Knotenpunkt-NBG/forcelog-adc/pcb/pcb_motherboard_dev/doku/pcb_motherboard_dev.png

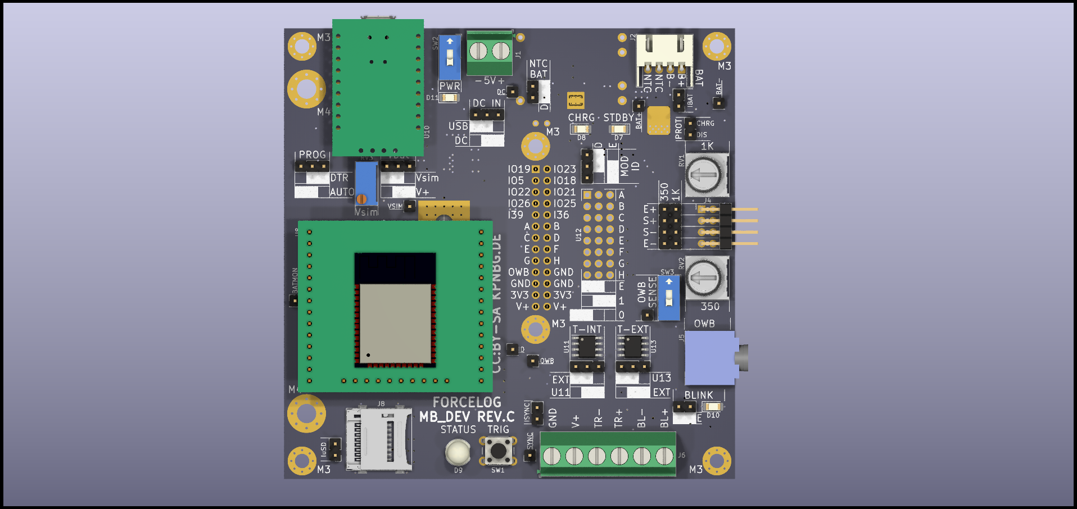
pcb/pcb_motherboard_dev/doku/pcb_motherboard_dev.png
