Knotenpunkt-NBG/forcelog-adc/firmware_forcelogADC/diagrams/flow_at_boot.pdf

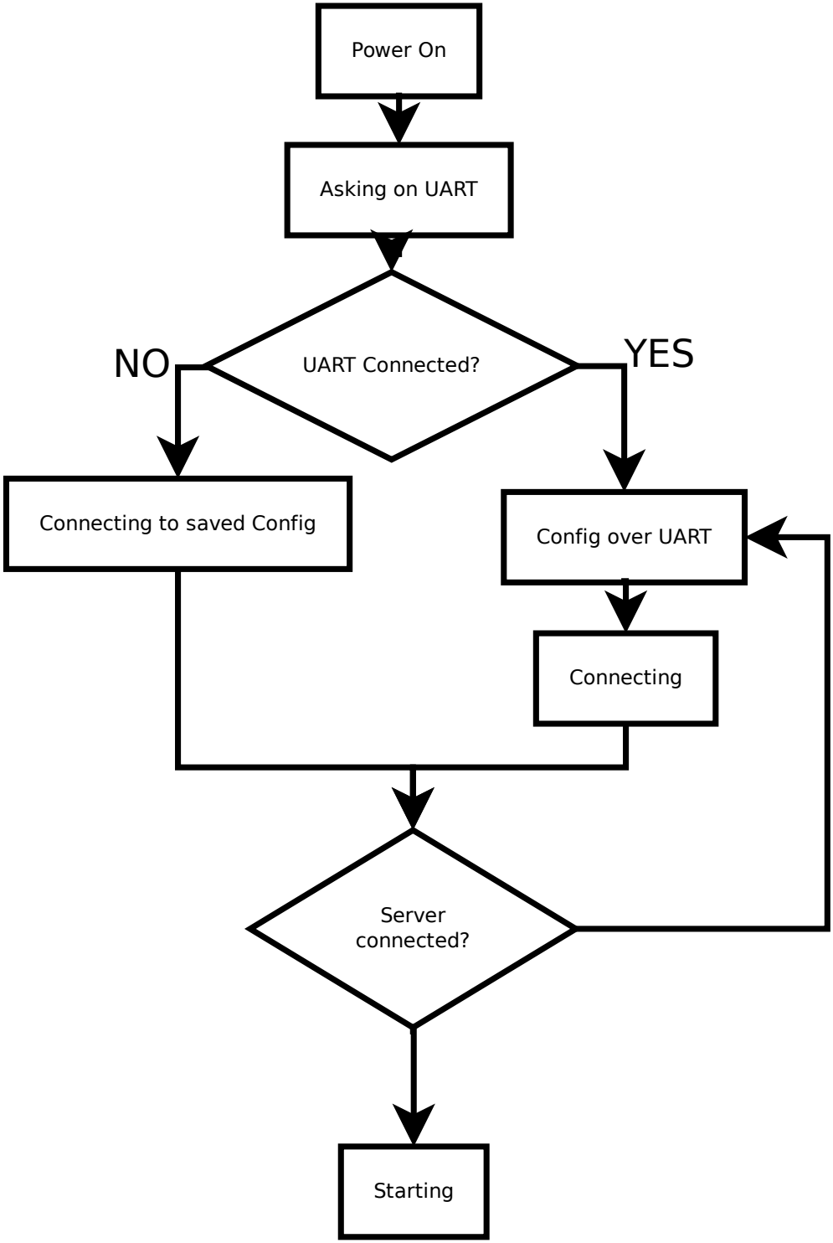
[picture p2: figure]
Power On; Asking on UART; UART Connected?; Connecting to saved Config; Config over UART; Connecting; Server connected?; Starting; YES
