Knotenpunkt-NBG/forcelog-adc/bom.ods

Stk | Value | Datasheet | da? | Prize | Gesamt
Reichelt |  |  |  |  |  | 267.79 | 435.14
8 | 10µ CER | https://www.reichelt.de/vielschicht-kerko-10-f-16v-125-c-kem-x7r1206-10u-p207163.html?trstct=pol_0&nbc=1 | 0 | 0.13 | 1.04
45 | 10µ Elko | https://www.reichelt.de/smd-elko-10-f-50-v-2000-h-eln-rv2-50v100mu-p246741.html?&trstct=pol_2&nbc=1 | 0 | 0.11 | 4.95
8 | 1n | https://www.reichelt.de/vielschicht-kerko-1-0nf-50v-125-c-kem-x7r1206-1-0n-p207139.html?trstct=pol_4&nbc=1 | 0 | 0.02 | 0.16
4 | 47n | https://www.reichelt.de/vielschicht-kerko-47nf-100v-125-c-kem-x7r1206-47n-p207148.html?trstct=pol_4&nbc=1 | 0 | 0.08 | 0.32
4 | 82n CER | https://www.reichelt.de/vielschicht-kerko-82nf-50v-125-c-kem-x7r1206-82n-p207150.html?trstct=pol_0&nbc=1 | 0 | 0.09 | 0.36
111 | 100n | https://www.reichelt.de/vielschicht-kerko-100nf-50v-125-c-kem-x7r1206b100n-p207152.html?trstct=pol_0&nbc=1 | 0 | 0.04 | 4.44
15 | 1µ | https://www.reichelt.de/vielschicht-kerko-1-0-f-25v-85-c-kem-y5v1206-1-0u-p207164.html?trstct=pol_0&nbc=1 | 0 | 0.05 | 0.75
2 | 2µ2 | https://www.reichelt.de/smd-kerko-1206-2-2-f-10-v-10-mlcc-rnd-1501206b2251-p225544.html?trstct=pol_0&nbc=1 | 0 | 0.02 | 0.04
20 | BAT54 | https://www.reichelt.de/schottkydiode-30-v-0-2-a-sod-323f-bat-54j-nxp-p219408.html?trstct=pos_9&nbc=1 | 0 | 0.06 | 1.2
2 | 1N4148 | https://www.reichelt.de/schalt-diode-75-v-150-ma-sod-323f-1n-4148-ws-p95197.html?&trstct=pos_3&nbc=1 | 0 | 0.04 | 0.08
8 | Terminal Block 2p | https://www.reichelt.de/loetbare-schraubklemme-2-pol-rm-5-mm-90-rnd-205-00012-p170244.html?trstct=pol_3&nbc=1 | 0 | 0.2 | 1.6
8 | Terminal Block 4p | https://www.reichelt.de/loetbare-schraubklemme-4-pol-rm-5-mm-90-rnd-205-00003-p170224.html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 | 0 | 0.35 | 2.8
4 | Terminal Block 5p | https://www.reichelt.de/loetbare-schraubklemme-5-pol-rm-5-mm-90-rnd-205-00004-p170225.html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 | 0 | 0.45 | 1.8
4 | 470 THT | https://www.reichelt.de/widerstand-metallschicht-470-ohm-0207-0-6-w-1-metall-470-p11826.html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 | 0 | 0.08 | 0.32
4 | 910 THT | https://www.reichelt.de/widerstand-metallschicht-910-ohm-0207-0-6-w-1-metall-910-p12035.html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 | 0 | 0.08 | 0.32
10 | 100 | https://www.reichelt.de/smd-widerstand-1206-100-ohm-250-mw-1-rnd-1206-1-100-p183349.html?trstct=pol_1&nbc=1 | 0 | 0.02 | 0.2
6 | 100 0.1% | https://www.reichelt.de/smd-widerstand-1206-100-ohm-250-mw-0-1-pan-era8aeb101v-p238078.html?trstct=pol_1&nbc=1 | 0 | 0.4 | 2.4
4 | 1k 0.1% | https://www.reichelt.de/smd-widerstand-1206-1-0-kohm-250-mw-0-1-pan-era8aeb102v-p238079.html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 | 0 | 0.4 | 1.6
4 | 150 | https://www.reichelt.de/smd-widerstand-1206-150-ohm-250-mw-1-rnd-1206-1-150-p183351.html?trstct=pol_0&nbc=1 | 0 | 0.02 | 0.08
5 | 270 | https://www.reichelt.de/smd-widerstand-1206-270-ohm-250-mw-1-rnd-1206-1-270-p183355.html?trstct=pol_0&nbc=1 | 0 | 0.02 | 0.1
22 | 470 | https://www.reichelt.de/smd-widerstand-1206-470-ohm-250-mw-1-rnd-1206-1-470-p183358.html?trstct=pol_0&nbc=1 | 0 | 0.02 | 0.44
5 | 750 | https://www.reichelt.de/smd-widerstand-1206-750-ohm-250-mw-1-koa-rk73h2bttd71-p238075.html?trstct=pol_2&nbc=1 | 0 | 0.02 | 0.1
13 | 910 | https://www.reichelt.de/smd-widerstand-1206-910-ohm-250-mw-1-rnd-1206-1-910-p212738.html?trstct=pol_0&nbc=1 | 0 | 0.02 | 0.26
5 | 1k5 | https://www.reichelt.de/smd-widerstand-1206-1-5-kohm-250-mw-1-rnd-1206-1-1-5k-p183381.html?trstct=pol_0&nbc=1 | 0 | 0.02 | 0.1
9 | 120 | https://www.reichelt.de/smd-widerstand-1206-120-ohm-250-mw-1-rnd-1206-1-120-p183350.html?trstct=pol_1&nbc=1 | 0 | 0.02 | 0.18
9 | 91 | https://www.reichelt.de/smd-widerstand-1206-91-ohm-250-mw-1-rnd-1206-1-91-p212729.html?trstct=pol_0&nbc=1 | 0 | 0.02 | 0.18
20 | 22 | https://www.reichelt.de/smd-widerstand-1206-22-ohm-250-mw-1-rnd-1206-1-22-p183340.html?trstct=pol_0&nbc=1 | 0 | 0.02 | 0.4
80 | 10k | https://www.reichelt.de/smd-widerstand-1206-10-kohm-250-mw-1-rnd-1206-1-10k-p183394.html?trstct=pol_1&nbc=1 | 0 | 0.02 | 1.6
4 | 1k | https://www.reichelt.de/smd-widerstand-1206-1-0-kohm-250-mw-1-rnd-1206-1-1-0k-p183379.html?trstct=pol_1&nbc=1 | 0 | 0.02 | 0.08
4 | 1k | https://www.reichelt.de/praezisionspotentiometer-25-gaenge-stehend-1-0-kohm-64w-1-0k-p2694.html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 | 0 | 0.31 | 1.24
6 | 7805 | https://www.reichelt.de/spannungsregler-fest-5-v-dpak-mc-7805-cdtg-p189143.html?&trstct=pos_8&nbc=1 | 0 | 0.35 | 2.1
6 | 74HC165 | https://www.reichelt.de/shift-register-8-bit-2-6-v-so-16-74hc-165d-nxp-p216626.html?trstct=pos_2&nbc=1 | 0 | 0.24 | 1.44
6 | DS18B20 | https://www.reichelt.de/digital-thermometer-1-wire-0-5-c-to-92-ds-18b20-p58169.html?trstct=pos_0&nbc=1 | 0 | 1.65 | 9.9
24 | 20Pin | https://www.reichelt.de/20pol-buchsenleiste-gerade-rm-2-54-h-8-5mm-bl-1x20g8-2-54-p51827.html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 | 0 | 0.27 | 6.48
19 | 40Pin | https://www.reichelt.de/40pol-stiftleiste-gerade-rm-2-54-sl-1x40g-2-54-p19506.html?trstct=pol_0&nbc=1 | 0 | 0.22 | 4.18
56 | Jumper | https://www.reichelt.de/kurzschlussbruecke-schw-m-grifflasche-jumper-2-54gl-sw-p9019.html?trstct=pol_2&nbc=1 | 0 | 0.03 | 1.68
17 | JST XH2P | https://www.reichelt.de/jst-stiftleiste-gerade-1x2-polig-xh-jst-xh2p-st-p185073.html?trstct=pos_7&nbc=1 | 0 | 0.08 | 1.36
15 | JST XH 4P | https://www.reichelt.de/jst-stiftleiste-gerade-1x4-polig-xh-jst-xh4p-st-p185075.html?trstct=pol_12&nbc=1 | 0 | 0.15 | 2.25
7 | JST XH 5P | https://www.reichelt.de/jst-stiftleiste-90-1x5-polig-xh-jst-xh5p-st90-p185082.html?trstct=pos_0&nbc=1 | 0 | 0.17 | 1.19
1 | JST XH8P | https://www.reichelt.de/jst-stiftleiste-gerade-1x8-polig-xh-jst-xh8p-st-p185078.html?trstct=pos_0&nbc=1 | 0 | 0.25 | 0.25
8 | 2N7002 | https://www.reichelt.de/mosfet-n-ch-60v-0-115a-0-3w-sot-23-2n-7002-7-f-p219153.html?trstct=pos_2&nbc=1 | 0 | 0.03 | 0.24
5 | KFV 80 | https://www.reichelt.de/einbaukupplung-frontmontage-ip40-8-pol-lum-kfv-80-p116111.html?trstct=pos_0&nbc=1 | 0 | 4.1 | 20.5
5 | KFV 40 | https://www.reichelt.de/einbaukupplung-frontmontage-ip40-4-pol-lum-kfv-40-p116109.html?trstct=pos_0&nbc=1 | 0 | 2.75 | 13.75
5 | KFV 50 | https://www.reichelt.de/einbaukupplung-frontmontage-ip40-5-pol-180-lum-kfv-50-p116110.html?trstct=pol_4&nbc=1 | 0 | 3.2 | 16
12 | Jst XH 2p FEM | https://www.reichelt.de/jst-buchsengehaeuse-1x2-polig-xh-jst-xh2p-bu-p185085.html?trstct=pos_2&nbc=1 | 0 | 0.04 | 0.48
20 | Jst XH 4p FEM | https://www.reichelt.de/jst-buchsengehaeuse-1x4-polig-xh-jst-xh4p-bu-p185087.html?trstct=pos_2&nbc=1 | 0 | 0.06 | 1.2
7 | Jst XH 5p FEM | https://www.reichelt.de/jst-buchsengehaeuse-1x5-polig-xh-jst-xh5p-bu-p185088.html?trstct=pos_1&nbc=1 | 0 | 0.04 | 0.28
1 | Jst XH 8p FEM | https://www.reichelt.de/jst-buchsengehaeuse-1x8-polig-xh-jst-xh8p-bu-p185090.html?trstct=pos_0&nbc=1 | 0 | 0.25 | 0.25
200 | Crimp JST XH | https://www.reichelt.de/jst-crimpkontakt-buchse-xh-jst-xh-ckb-p185091.html?&trstct=pol_0&nbc=1 | 0 | 0.03 | 6 |  | 147
2 | LTC2440CGN | https://www.reichelt.de/index.html?ACTION=446&LA=446&nbc=1&q=ltc2440 | 0 | 12.3 | 24.6
1 | Alugehäuse | https://www.reichelt.de/alugehaeuse-26-x-34-6-x-86-6-mm-aluminium-rnd-455-00848-p222399.html?r=1 | 0 | 2.2 | 2.2
1 | Kabel | https://www.reichelt.de/unitronic-liyy-50-m-8-x-0-25-liyy-8x0-25-50-p166031.html?&trstct=pol_0&nbc=1 | 0 | 31.6 | 31.6
1 | Kabel | https://www.reichelt.de/unitronic-liycy-50-m-4-x-0-25-liycy-4x0-25-50-p165979.html?trstct=vrt_pdn&nbc=1 | 0 | 31.2 | 31.2
2 | Kabelverschraubung | https://www.reichelt.de/kabelverschraubung-m-12-x-1-5-3-7-mm-silbergrau-ip69k-lapp-53112000-p158642.html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 | 0 | 1.99 | 3.98
1 | 5mm grün | https://www.reichelt.de/led-5-mm-bedrahtet-gruen-620-mcd-10-evl-333-2sygc-s5-p230907.html?trstct=pol_2&nbc=1 | 0 | 0.08 | 0.08
1 | 5mm gelb | https://www.reichelt.de/led-5-mm-bedrahtet-gelb-4200-mcd-6-evl-383-2uyc-s53-p230927.html?trstct=pol_3&nbc=1 | 0 | 0.09 | 0.09
2 | 5mm blau | https://www.reichelt.de/led-5-mm-bedrahtet-blau-2000-mcd-10-led-el-5-2000bl-p156268.html?trstct=pol_5&nbc=1 | 0 | 0.14 | 0.28
1 | Stecker Micro USB | https://www.reichelt.de/micro-usb-stecker-typ-b-5-polig-usb-micro-st-p124013.html?trstct=pol_12&nbc=1 | 0 | 0.85 | 0.85
4 | M3x10 FF | https://www.reichelt.de/distanzhuelsen-metall-6-kant-m3-10mm-di-10mm-p7119.html?&trstct=pol_10&nbc=1 | 0 | 0.11 | 0.44
1 | Schrumpfschlauch | https://www.reichelt.de/schrumpfschlauch-box-12m-transparent-6-4mm-sdb-6-4-tr-p53811.html?trstct=pol_6&nbc=1 | 0 | 3.3 | 3.3
5 | Blue 5mm | https://www.reichelt.de/led-5-mm-bedrahtet-blau-4000-mcd-16-kbt-l-7113qbc-g-p230952.html?trstct=pol_1&nbc=1 | 0 | 0.52 | 2.6
5 | IR 5mm | https://www.reichelt.de/ir-led-850-nm-5-mm-hir-7373b-l289-p216812.html?&trstct=pos_9&nbc=1 | 0 | 0.23 | 1.15
5 | IR 5mm | https://www.reichelt.de/ir-led-940-nm-5-mm-ir-7373c-evl-p219706.html?&trstct=pos_10&nbc=1 | 0 | 0.13 | 0.65
5 | Lumberg SV 40 | https://www.reichelt.de/stecker-sv-40-rundsteckverbinder-gerade-ip40-4-pol-lum-sv-40-p136906.html?r=1 | 0 | 4.15 | 20.75
5 | SV 50 | https://www.reichelt.de/stecker-sv-50-rundsteckverbinder-gerade-ip40-5-pol-180-lum-sv-50-p248561.html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 | 0 | 4.15 | 20.75
1 | Lumberg SV80 | https://www.reichelt.de/stecker-sv-80-rundsteckverbinder-gerade-ip40-8-pol-lum-sv-80-p116087.html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 | 0 | 4.6 | 4.6
Banggood |  |  |  |  |  | 1.66
5 | FT232breakout | https://www.banggood.com/FT232RL-FT232-RS232-FTDI-Micro-USB-to-TTL-3_3V-5_5V-Serial-Adapter-Module-Download-Cable-for-Mini-Port-p-1599806.html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 | 1 | 2.78 | 0
9 | BoostConverter | https://www.banggood.com/DC-2V-24V-To-5V-28V-2A-Step-Up-Boost-Converter-Power-Supply-Module-Adjustable-Regulator-Board-p-1566600.html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 | 1 | 1.29 | 0
9 | BuckConverter | https://www.banggood.com/DC-DC-7-28V-to-5V-3A-Step-Down-Power-Supply-Module-Buck-Converter-Replace-LM2596-p-1536688.html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 | 1 | 1.23 | 0
9 | W25Q128 | https://www.banggood.com/W25Q32-W25Q128-Large-Capacity-FLASH-Storage-Module-Memory-Card-SPI-Interface-BV-FV-STM32-p-1595134.html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 | 1 | 1.28 | 0
7 | HX711 | https://www.banggood.com/3pcs-AD-Weighing-Sensor-Module-Dual-channel-24-bit-AD-Conversion-HX711-Shieding-p-1355706.html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 | 1 | 0.97 | 0
5 | TP4056withprotect | https://www.banggood.com/TP4056-Micro-USB-5V-1A-Lithium-Battery-Charging-Module-Board-TE585-Lipo-Charger-p-1225993.html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 | 1 | 1.26 | 0
5 | Battery Holder | https://www.banggood.com/DIY-1-Slot-18650-Battery-Holder-With-2-Leads-p-972775.html?rmmds=search | 1 | 1.38 | 0
5 | Button | https://www.banggood.com/DC-12V-4-Pin-12mm-Latching-Switch-Led-Light-Metal-Push-Button-Switch-p-1196609.html?ID=229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 | 1 | 3.04 | 0
1 | RGB LED | https://www.banggood.com/10pcs-5mm-RGB-LED-Common-Anode-4-Pin-Tri-Color-Emitting-Diodes-F5-p-937446.html?ID=513798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 | 0 | 1.66 | 1.66
Aliexpress |  |  |  |  |  | 0
3 | Antenne SMA | https://de.aliexpress.com/item/32971789201.html?spm=a2g0s.9042311.0.0.720a4c4drGYyPu | 1 | 1.5 | 0
1 | Kabel | https://www.aliexpress.com/item/4000515927742.html?spm=a2g0s.9042311.0.0.7b694c4d2qJnZR | 1 | 10.29 | 0
5 | 5cm SMA-u.FL | https://www.aliexpress.com/item/4000339663959.html?spm=a2g0s.9042311.0.0.7b694c4d2qJnZR | 1 | 0.44 | 0
Digikey |  |  |  |  |  | 156.81
4 | ESP32-wroom-32 | https://www.digikey.de/product-detail/en/espressif-systems/ESP32-WROOM-32-16MB/1904-1020-1-ND/9381729 | 0 | 4.13 | 16.52
5 | ESP32-WROOM-32U | https://www.digikey.de/product-detail/en/espressif-systems/ESP32-WROOM-32U-16MB/1904-1028-1-ND/9381737 | 0 | 4.13 | 20.65
10 | Shield | https://www.digikey.de/product-detail/en/te-connectivity-amp-connectors/2118726-2/A126157CT-ND/7381917 | 0 | 1.42 | 14.2
10 | Shield Cover | https://www.digikey.de/product-detail/en/2118725-2/A126130-ND/7381869/?itemSeq=321839437 | 0 | 0.61 | 6.1
5 | Si4403DDY | https://www.digikey.de/product-detail/en/vishay-siliconix/SI4403DDY-T1-GE3/SI4403DDY-T1-GE3CT-ND/7622821 | 0 | 0.42 | 2.1
5 | 1550Z113 | https://www.digikey.de/product-detail/en/hammond-manufacturing/1550Z113/HM190-ND/2268551 | 0 | 12.88 | 64.4
6 | LED Mount | https://www.digikey.de/products/en?keywords=1528-1397-ND | 0 | 0.59 | 3.54
4 | IRF7343PBF | https://www.digikey.de/product-detail/en/infineon-technologies/IRF7343TRPBF/IRF7343PBFCT-ND/812557 | 0 | 0.95 | 3.8
4 | 10 0.1% | https://www.digikey.de/product-detail/en/bourns-inc/CRT1206-BY-10R0ELF/CRT1206-BY-10R0ELFCT-ND/1775050 | 0 | 0.59 | 2.36
2 | LT1492 | https://www.digikey.de/product-detail/en/linear-technology-analog-devices/LT1492CS8-PBF/LT1492CS8-PBF-ND/889428 | 0 | 8.12 | 16.24
2 | lt1461 | https://www.digikey.de/product-detail/en/linear-technology-analog-devices/LT1461CCS8-3-PBF/LT1461CCS8-3-PBF-ND/889264 | 0 | 3.45 | 6.9
Wegertseder |  |  |  |  |  | 8.88
50 | ISO7380 M4x8 | https://www.wegertseder.com/ArticleDetails.aspx?AKNUM=2576&Diameter=4 | 0 | 0.039 | 1.95
100 | Iso7380 M3x6 | https://www.wegertseder.com/ArticleDetails.aspx?AKNUM=2576&Diameter=3 | 0 | 0.0238 | 2.38
100 | DIN 7991 M4x20 | https://www.wegertseder.com/ArticleDetails.aspx?AKNUM=2608&Diameter=4 | 0 | 0.0455 | 4.55
