Knotenpunkt-NBG/forcelog-adc/mechanical/ENCLOSURE_1550Z113_LID.step

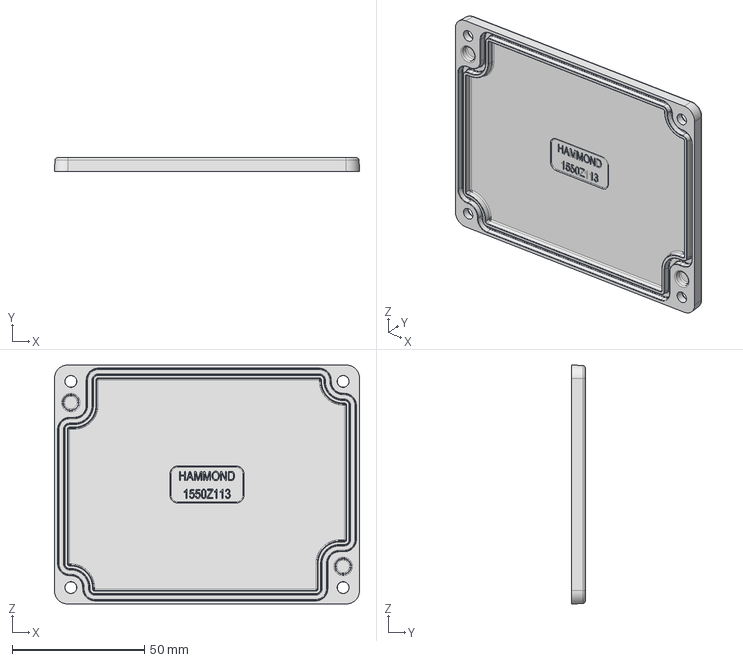
[picture p4: CAD file, 2021-02-28]
mechanical/ENCLOSURE_1550Z113_LID.step
115.4 x 5.20 x 90.4 mm
