Knotenpunkt-NBG/forcelog-adc/mechanical/ENCLOSURE_1550Z113_BOX.step

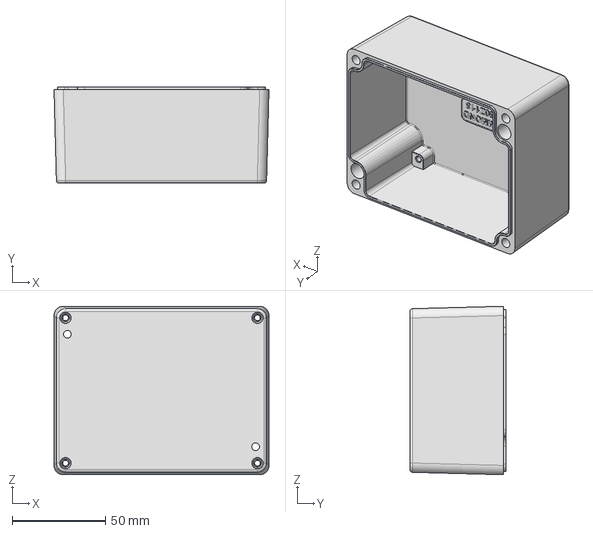
[picture p5: CAD file, 2021-02-28]
mechanical/ENCLOSURE_1550Z113_BOX.step
115.4 x 51.7 x 90.4 mm
