Knotenpunkt-NBG/forcelog-adc/(list of files, cad)

Other CAD files:
mechanical/FORCELOG_ADC_MAIN.FCStd
mechanical/ENCLOSURE_1550Z113_BOX.FCStd
