Knotenpunkt-NBG/forcelog-adc/firmware_forcelogADC/styleguide.ods

StyleGuide
Handler:
h_divide_name
Tasks
t_camelCase
Variables
f_CamelCase
Key:
k_camelCase
Function
camelCase
