Knotenpunkt-NBG/forcelog-adc/(threads)

Thread 2 (2021-12-22):

Acks geradeziehen

knoterich, 2021-12-22:
Bei zweistufigen Eingaben soll bei Eingabeaufforderung \1|\2user\3| an den collector geschickt werden und kein Ack.

knoterich, 2021-12-22:
für Errors sollen auch die entsprechenden Befehle zuückgeben (e.g. |bdur|0) und nicht |err|
