Knotenpunkt-NBG/forcelog-adc/pcb/pcb_motherboard_dev/pcb_motherboard_dev.kicad_pcb

## KiCad design pcb/pcb_motherboard_dev/pcb_motherboard_dev.kicad_pcb (2022-08-03)

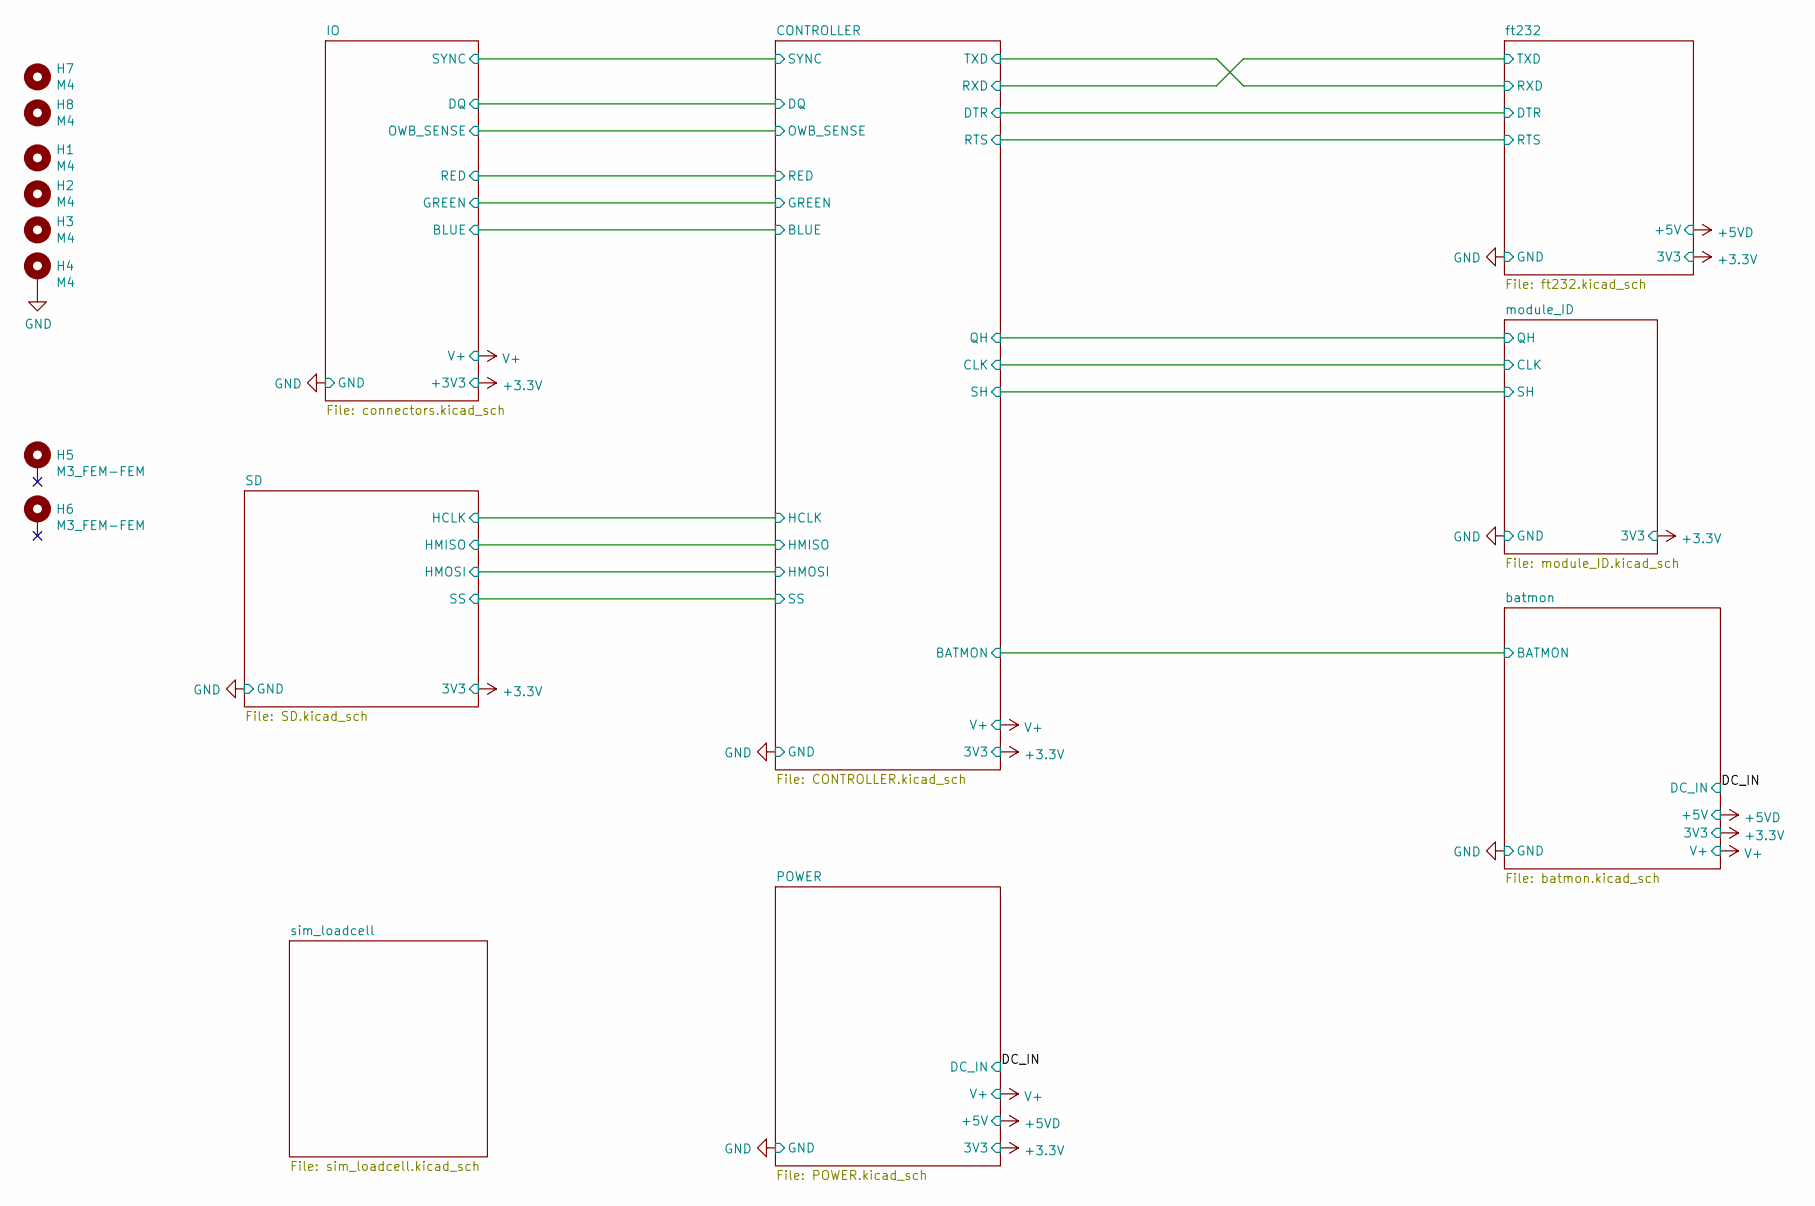
[picture p6: schematic pcb_motherboard_dev.kicad_sch]

Parts:
H1, H7: M4; MountingHole_4.3mm_M4_Pad_Via
H2, H3, H4, H8: M4; MountingHole_3.2mm_M3_Pad_Via
H5, H6: M3_FEM-FEM; MountingHole_3.2mm_M3_Pad_Via

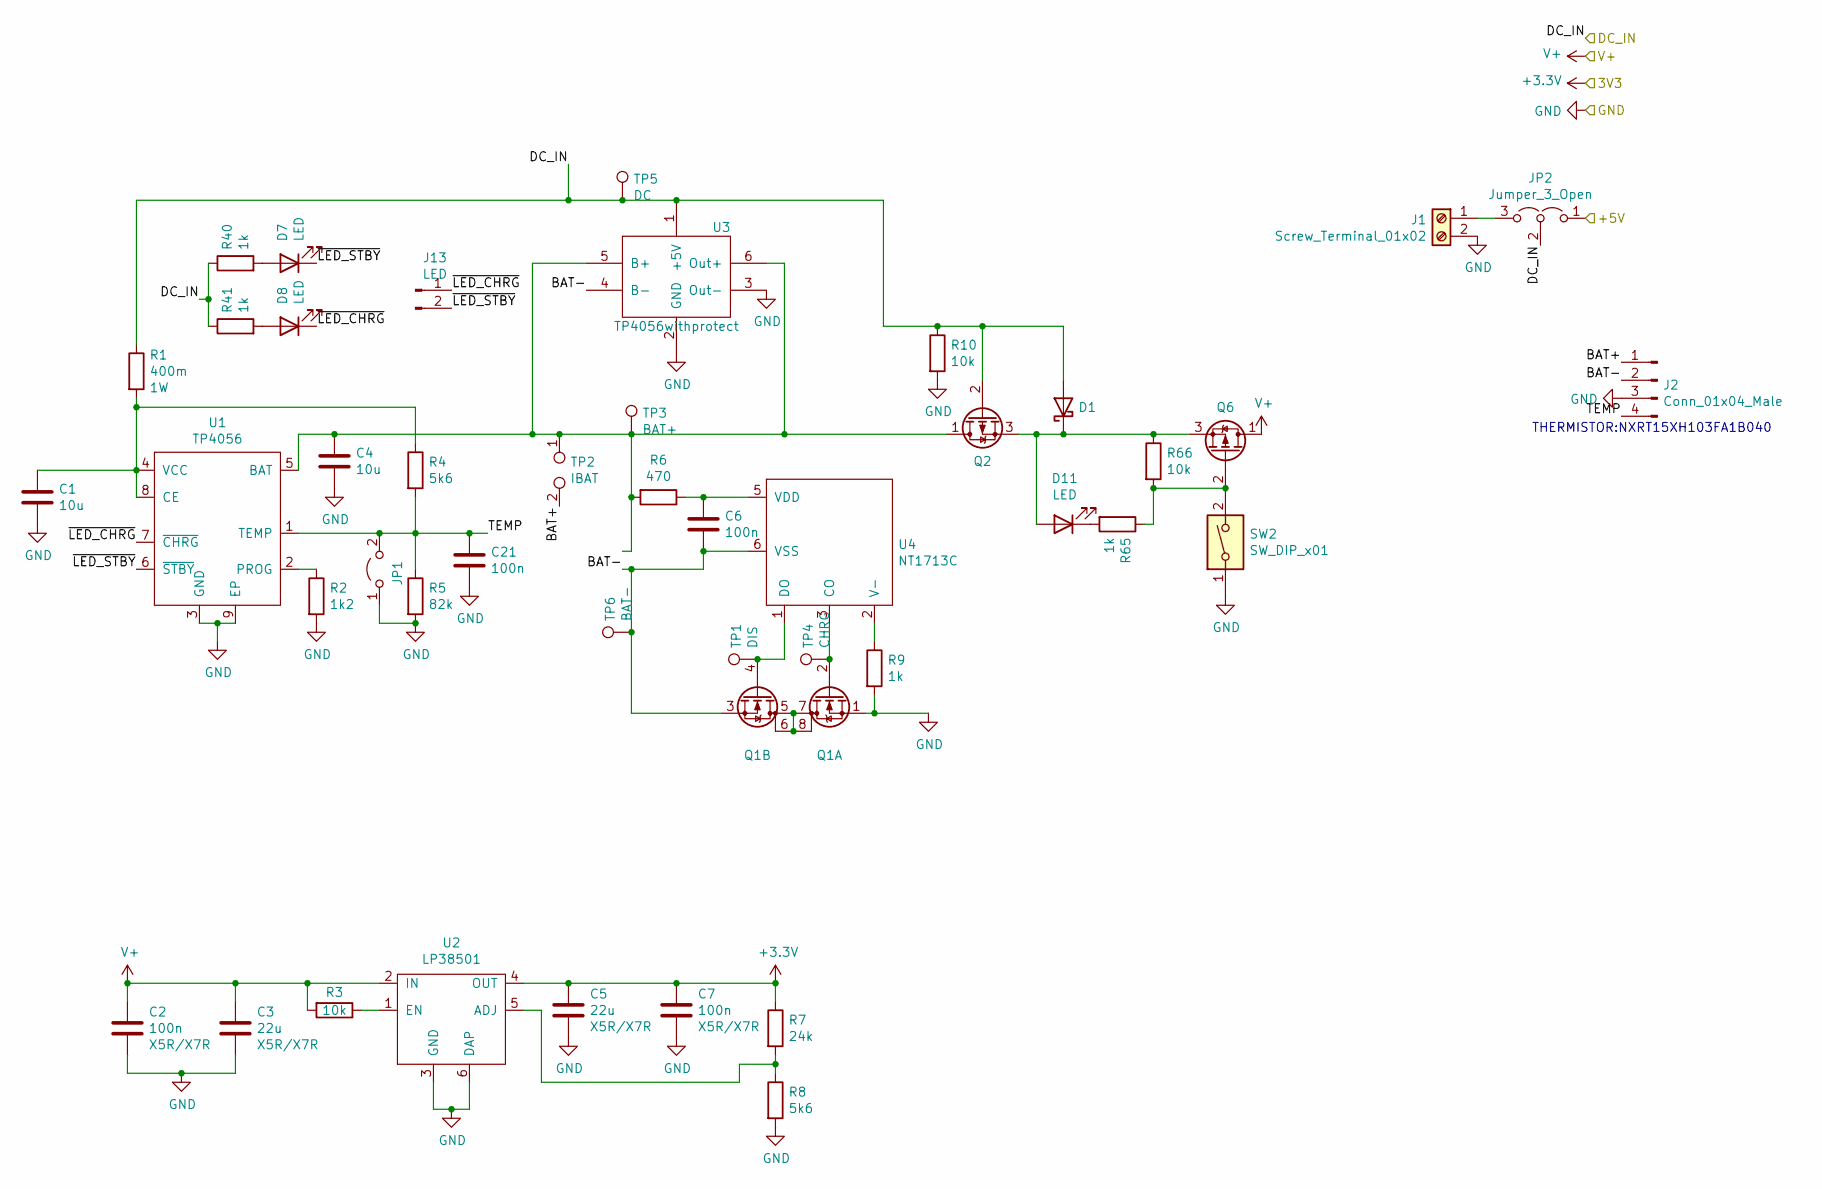
[picture p7: schematic POWER.kicad_sch]

Parts:
C1, C4: 10u; C_1206_3216Metric_Pad1.33x1.80mm_HandSolder; Digikey 1276-1075-1-ND
C2, C6, C7, C21: 100n; C_1206_3216Metric_Pad1.33x1.80mm_HandSolder; Digikey 399-C1206C104K5RAC7800CT-ND
C3, C5: 22u; C_1206_3216Metric_Pad1.33x1.80mm_HandSolder; Digikey 1276-2728-1-ND
D1: PMEG3030EP,115; D_SOD-128; Digikey 1727-5324-1-ND
D7, D11: LED; LED_1206_3216Metric_Pad1.42x1.75mm_HandSolder; Digikey 732-5032-1-ND
D8: LED; LED_1206_3216Metric_Pad1.42x1.75mm_HandSolder; Digikey 732-5034-1-ND
J1: Screw_Terminal_01x02; TerminalBlock_Phoenix_MKDS-1,5-2_1x02_P5.00mm_Horizontal; Digikey 277-16667-ND
J2: Conn_01x04_Male; JST_XH_S4B-XH-A-1_1x04_P2.50mm_Horizontal; Digikey 455-4227-ND
J13: LED; TestPoint_2Pads_Pitch2.54mm_Drill0.8mm
JP1: Jumper_2_Open; PinHeader_1x02_P2.54mm_Vertical
JP2: Jumper_3_Open; PinHeader_1x03_P2.54mm_Vertical
Q1: DMG9926USD; SO-8_3.9x4.9mm_P1.27mm; Digikey DMG9926USD-13DICT-ND
Q2, Q6: IRF7410TRPBF; SO8_3.8x4.8_SSSGDDDD; Digikey IRF7410TRPBF
R1: 400m; R_2512_6332Metric_Pad1.40x3.35mm_HandSolder; LCSC C165323
R2: 1k2; R_1206_3216Metric_Pad1.30x1.75mm_HandSolder; LCSC C185265
R3, R10, R66: 10k; R_1206_3216Metric_Pad1.30x1.75mm_HandSolder; LCSC C132649
R4, R8: 5k6; R_1206_3216Metric_Pad1.30x1.75mm_HandSolder; LCSC C137248
R5: 82k; R_1206_3216Metric_Pad1.30x1.75mm_HandSolder; LCSC C137229
R6: 470; R_1206_3216Metric_Pad1.30x1.75mm_HandSolder; LCSC C114945
R7: 24k; R_1206_3216Metric_Pad1.30x1.75mm_HandSolder; LCSC C163384
R9, R40, R41, R65: 1k; R_1206_3216Metric_Pad1.30x1.75mm_HandSolder; LCSC C131398
SW2: SW_DIP_x01; SW_DIP_SPSTx01_Slide_9.78x4.72mm_W7.62mm_P2.54mm; LCSC C229812
TP1: DIS; PinHeader_1x01_P2.54mm_Vertical
TP2: IBAT; PinHeader_1x02_P2.54mm_Vertical
TP3: BAT+; PinHeader_1x01_P2.54mm_Vertical
TP4: CHRG; PinHeader_1x01_P2.54mm_Vertical
TP5: DC; PinHeader_1x01_P2.54mm_Vertical
TP6: BAT-; PinHeader_1x01_P2.54mm_Vertical
U1: TP4056; SOIC-8-1EP_3.9x4.9mm_P1.27mm_EP2.29x3mm_ThermalVias; LCSC C191323
U2: LP38501; TO-263-5_TabPin6; LCSC C779671
U3: TP4056withprotect; TP4056_module_prot; Digikey N/A
U4: NT1713C; SOT-23-6_Handsoldering; LCSC C596362

Connections:
+5V: JP2.1 (A); also elsewhere on the board
/DC_IN: D1.2 (A), JP2.2 (C), Q2.2 (G), R1.1, R10.1, R40.1, R41.1, TP5.1, U3.1 (+5V); also elsewhere on the board
/POWER/BAT+: J2.1, TP2.2
/POWER/BAT-: C6.2, J2.2, Q1.3 (S), TP6.1, U3.4 (B-), U4.6 (VSS)
/POWER/TEMP: C21.1, J2.4, JP1.2 (B), R4.2, R5.1, U1.1 (TEMP)
/POWER/~LED_CHRG: D8.1 (K), J13.1, U1.7 (~CHRG)
/POWER/~LED_STBY: D7.1 (K), J13.2, U1.6 (~STBY)
unnamed: C1.1, R1.2, R4.1, U1.4 (VCC), U1.8 (CE)
unnamed: C4.1, Q2.1 (D), R6.2, TP2.1, TP3.1, U1.5 (BAT), U3.5 (B+), U3.6 (Out+)
unnamed: C6.1, R6.1, U4.5 (VDD)
unnamed: D1.1 (K), D11.2 (A), Q2.3 (S), Q6.3 (S), R66.1
unnamed: D7.2 (A), R40.2
unnamed: D8.2 (A), R41.2
unnamed: D11.1 (K), R65.2
unnamed: J1.1, JP2.3 (B)
unnamed: Q1.2 (G), TP4.1, U4.3 (CO)
unnamed: Q1.4 (G), TP1.1, U4.1 (DO)
unnamed: Q1.5 (D), Q1.6 (D), Q1.7 (D), Q1.8 (D)
unnamed: Q6.2 (G), R65.1, R66.2, SW2.2
unnamed: R2.1, U1.2 (PROG)
unnamed: R3.1, U2.1 (EN)
unnamed: R7.2, R8.1, U2.5 (ADJ)
unnamed: R9.1, U4.2 (V-)
V+: C2.1, C3.1, Q6.1 (D), R3.2, U2.2 (IN); also elsewhere on the board

Notes on the sheet:
THERMISTOR:NXRT15XH103FA1B040

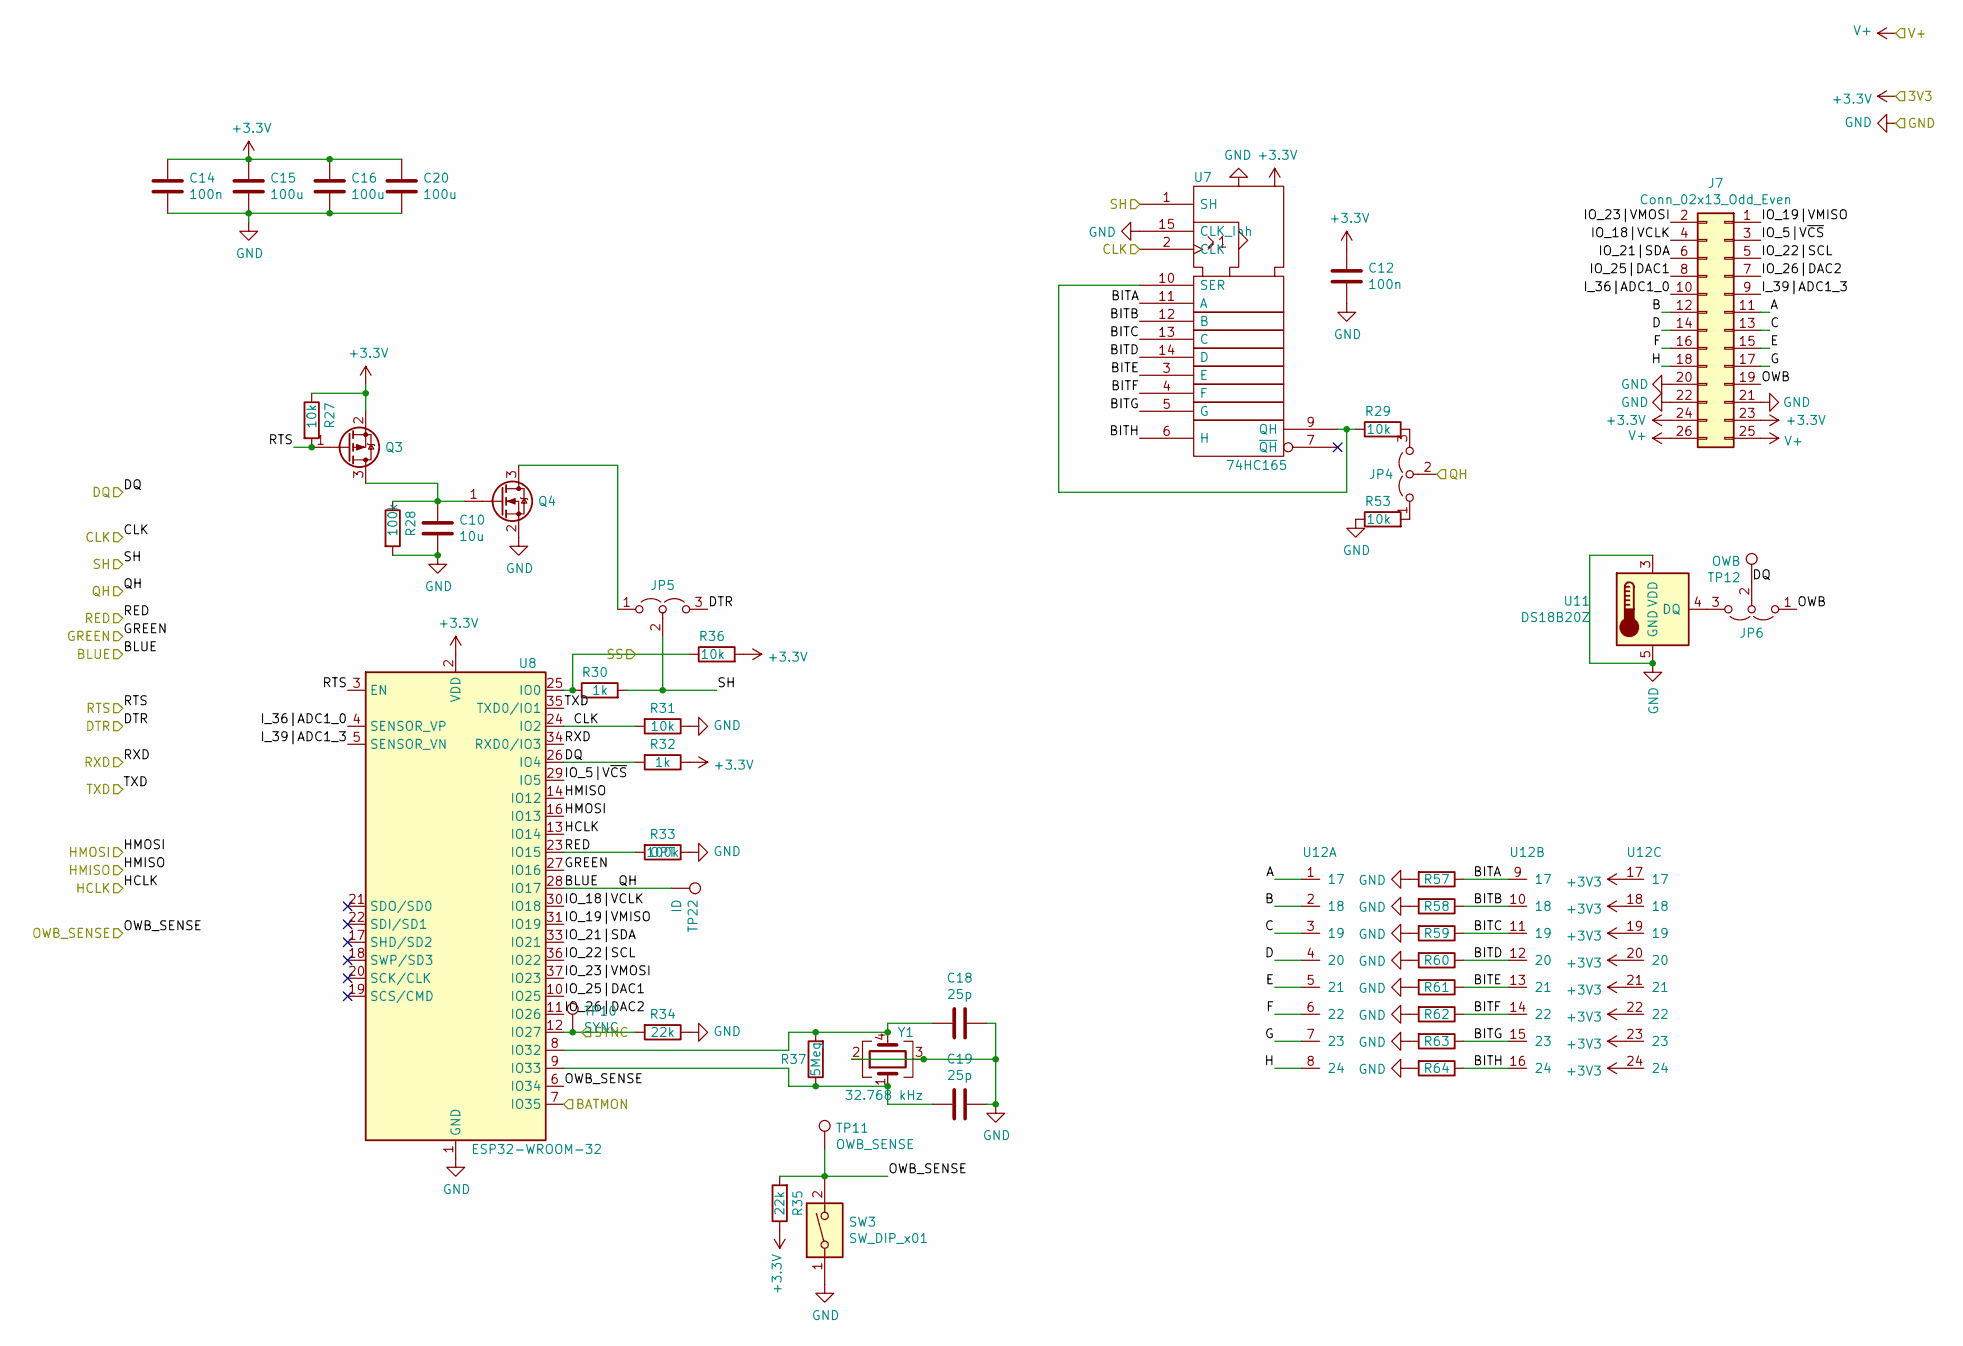
[picture p8: schematic CONTROLLER.kicad_sch]

Parts:
C10: 10u; C_1206_3216Metric_Pad1.33x1.80mm_HandSolder
C12, C14: 100n; C_1206_3216Metric_Pad1.33x1.80mm_HandSolder; Digikey 399-C1206C104K5RAC7800CT-ND
C15: 100u; C_1206_3216Metric_Pad1.33x1.80mm_HandSolder; Digikey 1276-1782-1-ND
C16, C20: 100u; C_1206_3216Metric_Pad1.33x1.80mm_HandSolder; LCSC C312983
C18, C19: 25p; C_1206_3216Metric_Pad1.33x1.80mm_HandSolder; Digikey N/A
J7: Conn_02x13_Odd_Even; PinSocket_2x13_P2.54mm_Vertical; LCSC C35165
JP4, JP5, JP6: Jumper_3_Open; PinHeader_1x03_P2.54mm_Vertical
Q3: IRLML2244TRPBF; SOT-23; Digikey IRLML2244TRPBFCT-ND
Q4: BSS806NE; SOT-23; LCSC C91714
R27, R29, R31, R36, R53, R57, R58, R59, R60, R61, R62, R63, R64: 10k; R_1206_3216Metric_Pad1.30x1.75mm_HandSolder; LCSC C132649
R28: 100k; R_1206_3216Metric_Pad1.30x1.75mm_HandSolder
R30, R32: 1k; R_1206_3216Metric_Pad1.30x1.75mm_HandSolder; LCSC C131398
R33: 100k; R_1206_3216Metric_Pad1.30x1.75mm_HandSolder; LCSC C137393
R34: 22k; R_1206_3216Metric_Pad1.30x1.75mm_HandSolder; LCSC C229456
R35: 22k; R_1206_3216Metric_Pad1.30x1.75mm_HandSolder; LCSC C132649
R37: 5Meg; R_1206_3216Metric_Pad1.30x1.75mm_HandSolder; LCSC C163371
SW3: SW_DIP_x01; SW_DIP_SPSTx01_Slide_9.78x4.72mm_W7.62mm_P2.54mm; LCSC C229812
TP10: SYNC; PinHeader_1x01_P2.54mm_Vertical
TP11: OWB_SENSE; PinHeader_1x01_P2.54mm_Vertical
TP12: OWB; PinHeader_1x01_P2.54mm_Vertical
TP22: ID; PinHeader_1x01_P2.54mm_Vertical
U7: 74HC165; SO-16_3.9x9.9mm_P1.27mm; LCSC C7334
U8: ESP32-WROOM-32; ESP32-WROOM-BREAKOUT
U11: DS18B20Z; SOIC-8_3.9x4.9mm_P1.27mm; LCSC C97190
U12: 2POS_JUMPER_8BIT
Y1: 32.768 kHz; Crystal_SMD_SeikoEpson_MC306-4Pin_8.0x3.2mm_HandSoldering; Digikey 300-8742-1-ND

Connections:
/CONTROLLER/A: J7.11, U12.1 (17)
/CONTROLLER/B: J7.12, U12.2 (18)
/CONTROLLER/BATMON: U8.7 (IO35); also elsewhere on the board
/CONTROLLER/BITA: R57.1, U7.11 (A), U12.9 (17)
/CONTROLLER/BITB: R58.1, U7.12 (B), U12.10 (18)
/CONTROLLER/BITC: R59.1, U7.13 (C), U12.11 (19)
/CONTROLLER/BITD: R60.1, U7.14 (D), U12.12 (20)
/CONTROLLER/BITE: R61.1, U7.3 (E), U12.13 (21)
/CONTROLLER/BITF: R62.1, U7.4 (F), U12.14 (22)
/CONTROLLER/BITG: R63.1, U7.5 (G), U12.15 (23)
/CONTROLLER/BITH: R64.1, U7.6 (H), U12.16 (24)
/CONTROLLER/BLUE: JP4.2 (C), TP22.1, U8.28 (IO17); also elsewhere on the board
/CONTROLLER/C: J7.13, U12.3 (19)
/CONTROLLER/CLK: R31.2, U7.2 (CLK), U8.24 (IO2)
/CONTROLLER/D: J7.14, U12.4 (20)
/CONTROLLER/DQ: JP6.2 (C), R32.2, TP12.1, U8.26 (IO4); also elsewhere on the board
/CONTROLLER/DTR: JP5.3 (B); also elsewhere on the board
/CONTROLLER/E: J7.15, U12.5 (21)
/CONTROLLER/F: J7.16, U12.6 (22)
/CONTROLLER/G: J7.17, U12.7 (23)
/CONTROLLER/GREEN: U8.27 (IO16); also elsewhere on the board
/CONTROLLER/H: J7.18, U12.8 (24)
/CONTROLLER/HCLK: U8.13 (IO14); also elsewhere on the board
/CONTROLLER/HMISO: U8.14 (IO12); also elsewhere on the board
/CONTROLLER/HMOSI: U8.16 (IO13); also elsewhere on the board
/CONTROLLER/IO_5|V~CS: J7.3, U8.29 (IO5)
/CONTROLLER/IO_18|VCLK: J7.4, U8.30 (IO18)
/CONTROLLER/IO_19|VMISO: J7.1, U8.31 (IO19)
/CONTROLLER/IO_21|SDA: J7.6, U8.33 (IO21)
/CONTROLLER/IO_22|SCL: J7.5, U8.36 (IO22)
/CONTROLLER/IO_23|VMOSI: J7.2, U8.37 (IO23)
/CONTROLLER/IO_25|DAC1: J7.8, U8.10 (IO25)
/CONTROLLER/IO_26|DAC2: J7.7, U8.11 (IO26)
/CONTROLLER/I_36|ADC1_0: J7.10, U8.4 (SENSOR_VP)
/CONTROLLER/I_39|ADC1_3: J7.9, U8.5 (SENSOR_VN)
/CONTROLLER/OWB: J7.19, JP6.1 (A)
/CONTROLLER/OWB_SENSE: R35.2, SW3.2, TP11.1, U8.6 (IO34); also elsewhere on the board
/CONTROLLER/RED: R33.2, U8.23 (IO15); also elsewhere on the board
/CONTROLLER/RTS: Q3.1 (G), R27.2, U8.3 (EN); also elsewhere on the board
/CONTROLLER/RXD: U8.34 (RXD0/IO3); also elsewhere on the board
/CONTROLLER/SH: JP5.2 (C), R30.2, U7.1 (SH)
/CONTROLLER/SS: R30.1, R36.1, U8.25 (IO0); also elsewhere on the board
/CONTROLLER/SYNC: R34.2, TP10.1, U8.12 (IO27); also elsewhere on the board
/ft232/RXD: U8.35 (TXD0/IO1); also elsewhere on the board
unnamed: C10.1, Q3.3 (D), Q4.1 (G), R28.1
unnamed: C18.2, R37.2, U8.8 (IO32), Y1.4
unnamed: C19.1, R37.1, U8.9 (IO33), Y1.1
unnamed: JP4.1 (A), R53.2
unnamed: JP4.3 (B), R29.2
unnamed: JP5.1 (A), Q4.3 (D)
unnamed: JP6.3 (B), U11.4 (DQ)
unnamed: R29.1, U7.9 (QH), U7.10 (SER)
V+: J7.25, J7.26; also elsewhere on the board

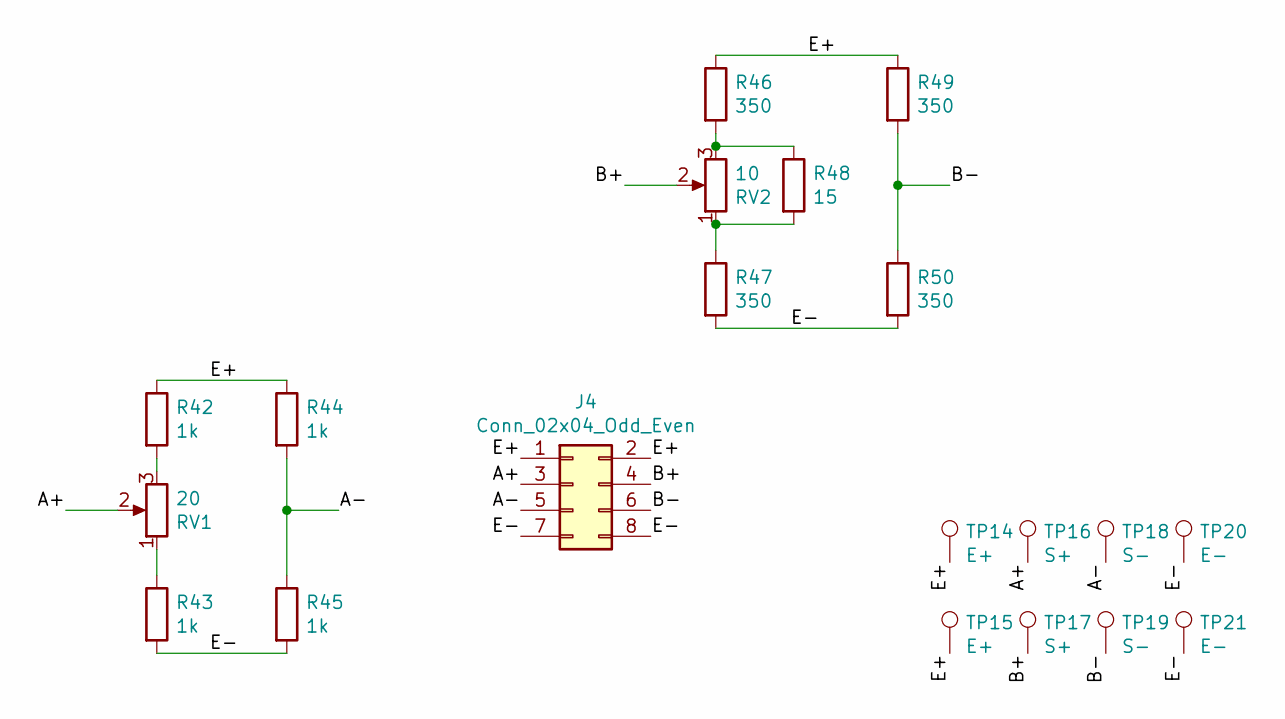
[picture p9: schematic sim_loadcell.kicad_sch]

Parts:
J4: Conn_02x04_Odd_Even; PinHeader_2x04_P2.54mm_Horizontal; LCSC C358706
R42, R43, R44, R45: 1k; R_1206_3216Metric_Pad1.30x1.75mm_HandSolder; LCSC C131398
R46, R47, R49, R50: 350; R_1206_3216Metric_Pad1.30x1.75mm_HandSolder; LCSC C163378
R48: 15; R_1206_3216Metric_Pad1.30x1.75mm_HandSolder; LCSC C137386
RV1: 20; Potentiometer_Bourns_3386P_Vertical; Digikey 3386P-1-200TLF-ND
RV2: 10; Potentiometer_Bourns_3386P_Vertical; LCSC C116299
TP14, TP15: E+; PinHeader_1x01_P2.54mm_Vertical
TP16, TP17: S+; PinHeader_1x01_P2.54mm_Vertical
TP18, TP19: S-; PinHeader_1x01_P2.54mm_Vertical
TP20, TP21: E-; PinHeader_1x01_P2.54mm_Vertical

Connections:
/sim_loadcell/A+: J4.3, RV1.2, TP16.1
/sim_loadcell/A-: J4.5, R44.2, R45.1, TP18.1
/sim_loadcell/B+: J4.4, RV2.2, TP17.1
/sim_loadcell/B-: J4.6, R49.2, R50.1, TP19.1
/sim_loadcell/E+: J4.1, J4.2, R42.1, R44.1, R46.1, R49.1, TP14.1, TP15.1
/sim_loadcell/E-: J4.7, J4.8, R43.2, R45.2, R47.2, R50.2, TP20.1, TP21.1
unnamed: R42.2, RV1.3
unnamed: R43.1, RV1.1
unnamed: R46.2, R48.1, RV2.3
unnamed: R47.1, R48.2, RV2.1

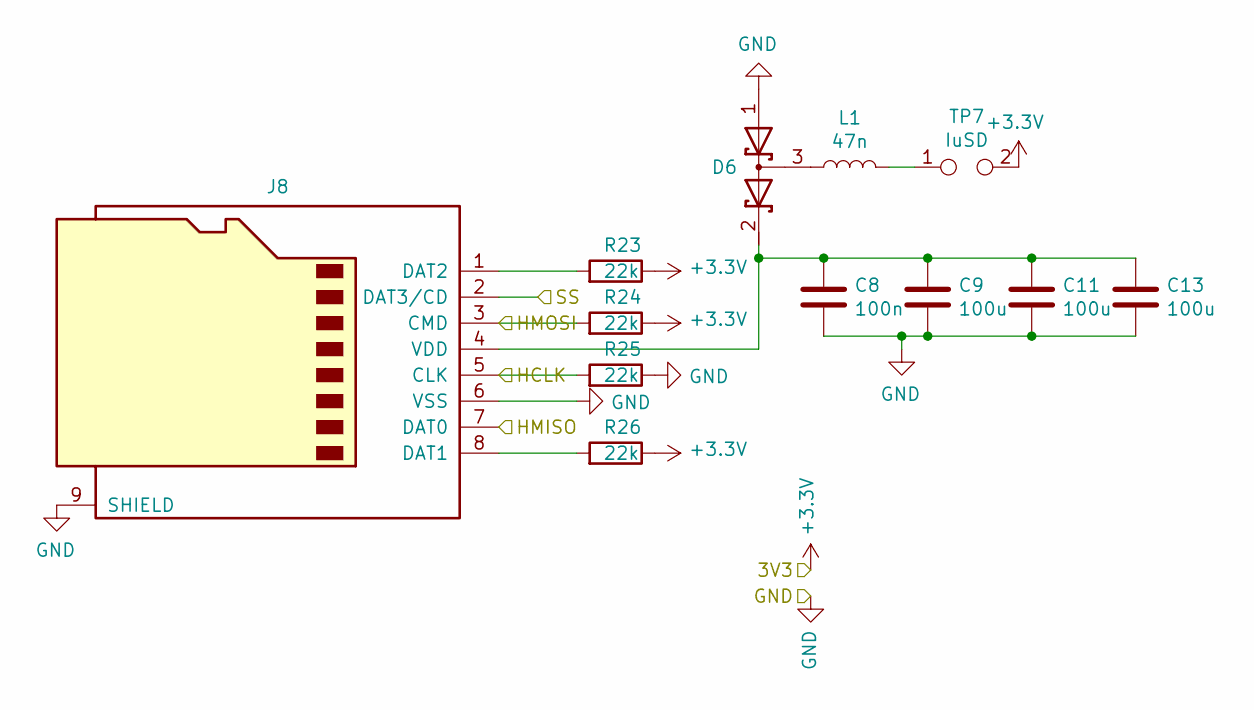
[picture p10: schematic SD.kicad_sch]

Parts:
C8: 100n; C_1206_3216Metric_Pad1.33x1.80mm_HandSolder; Digikey 399-C1206C104K5RAC7800CT-ND
C9: 100u; C_1206_3216Metric_Pad1.33x1.80mm_HandSolder; Digikey 1276-1782-1-ND
C11, C13: 100u; C_1206_3216Metric_Pad1.33x1.80mm_HandSolder; LCSC C312983
D6: BAT54S; SOT-23; Digikey 1727-1868-1-ND
J8: Micro_SD_Card; uSD_Molex_0472192001; Partnumber 472192001; Digikey WM6698CT-ND
L1: 47n; L_1210_3225Metric_Pad1.42x2.65mm_HandSolder; Digikey 445-16541-1-ND
R23, R24, R25, R26: 22k; R_1206_3216Metric_Pad1.30x1.75mm_HandSolder; LCSC C229456
TP7: IuSD; PinHeader_1x02_P2.54mm_Vertical

Connections:
/CONTROLLER/HCLK: J8.5 (CLK), R25.2; also elsewhere on the board
/CONTROLLER/HMISO: J8.7 (DAT0); also elsewhere on the board
/CONTROLLER/HMOSI: J8.3 (CMD), R24.2; also elsewhere on the board
/CONTROLLER/SS: J8.2 (DAT3/CD); also elsewhere on the board
unnamed: C8.1, C9.1, C11.1, C13.1, D6.2 (K), J8.4 (VDD)
unnamed: D6.3 (common), L1.1
unnamed: J8.1 (DAT2), R23.2
unnamed: J8.8 (DAT1), R26.2
unnamed: L1.2, TP7.1

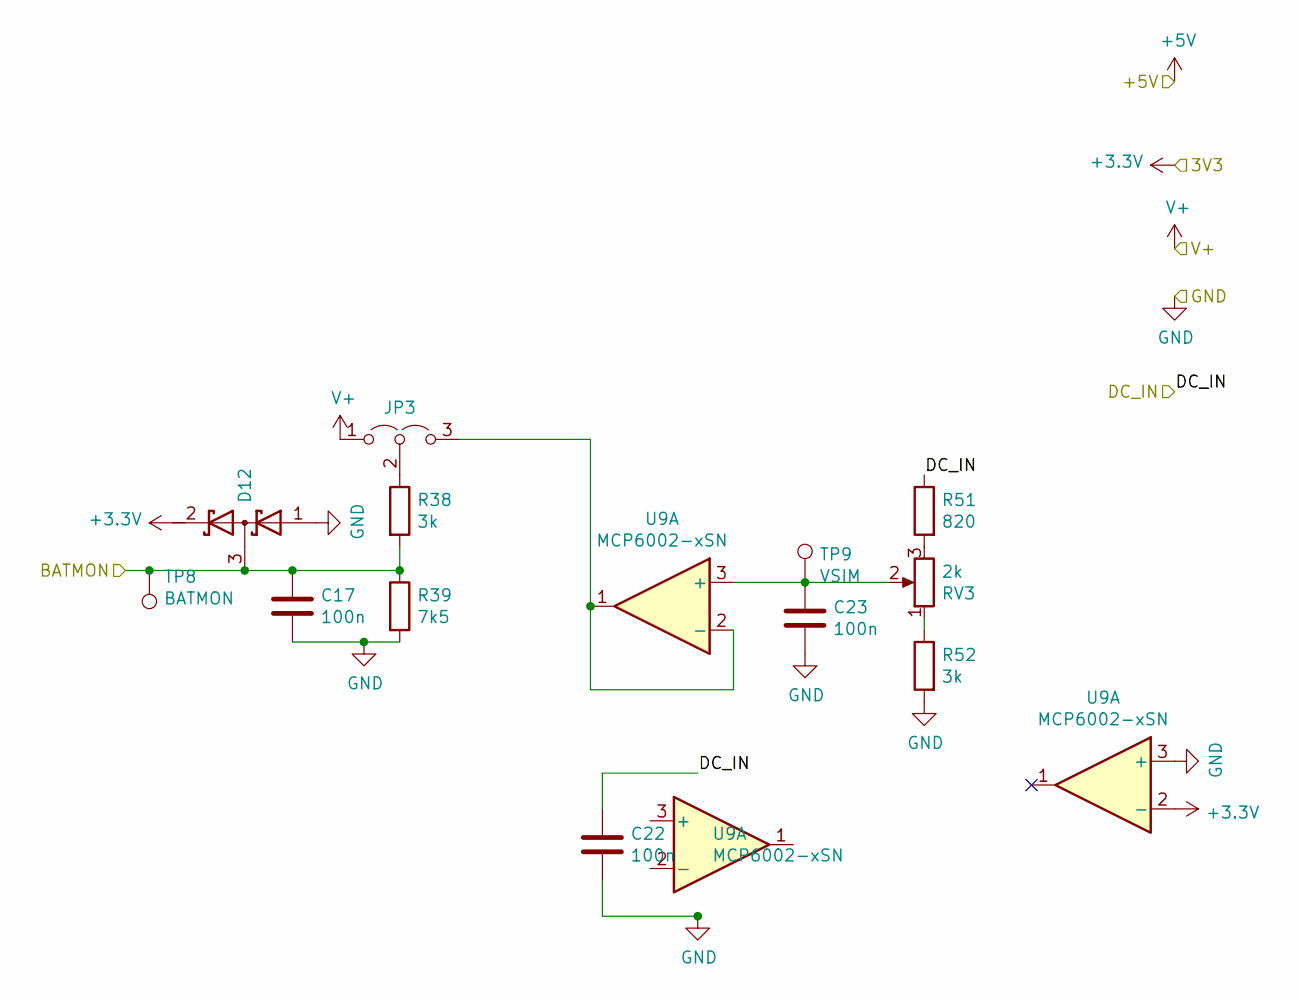
[picture p11: schematic batmon.kicad_sch]

Parts:
C17, C22, C23: 100n; C_1206_3216Metric_Pad1.33x1.80mm_HandSolder; Digikey 399-C1206C104K5RAC7800CT-ND
D12: BAT54S; SOT-23; Digikey 1727-1868-1-ND
JP3: Jumper_3_Open; PinHeader_1x03_P2.54mm_Vertical
R38, R52: 3k; R_1206_3216Metric_Pad1.30x1.75mm_HandSolder; LCSC C132648
R39: 7k5; R_1206_3216Metric_Pad1.30x1.75mm_HandSolder; LCSC C137232
R51: 820; R_1206_3216Metric_Pad1.30x1.75mm_HandSolder; LCSC C229812
RV3: 2k; Potentiometer_Bourns_3296W_Vertical; LCSC C118206
TP8: BATMON; PinHeader_1x01_P2.54mm_Vertical
TP9: VSIM; PinHeader_1x01_P2.54mm_Vertical
U9: MCP6002-xSN; SO-8_3.9x4.9mm_P1.27mm; LCSC C7377

Connections:
/CONTROLLER/BATMON: C17.1, D12.3 (common), R38.2, R39.1, TP8.1; also elsewhere on the board
/DC_IN: C22.1, R51.1, U9.8 (V+); also elsewhere on the board
unnamed: JP3.2 (C), R38.1
unnamed: R51.2, RV3.3
unnamed: R52.1, RV3.1
V+: JP3.1 (A); also elsewhere on the board

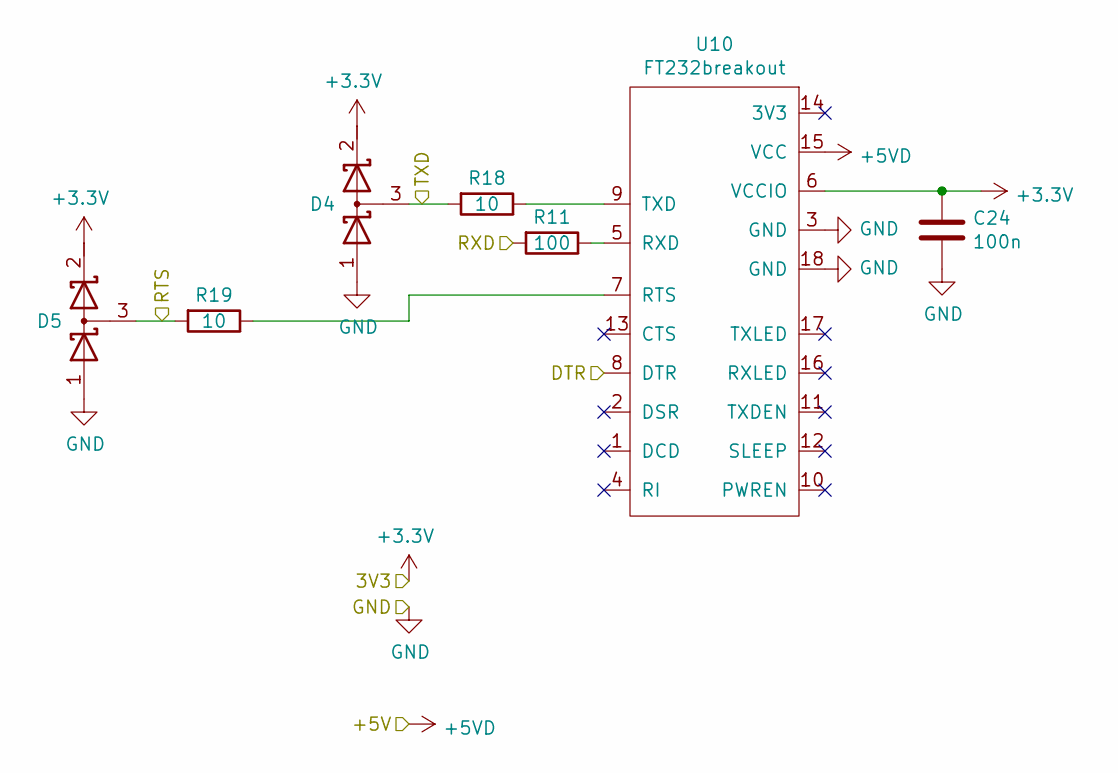
[picture p12: schematic ft232.kicad_sch]

Parts:
C24: 100n; C_1206_3216Metric_Pad1.33x1.80mm_HandSolder; Digikey 399-C1206C104K5RAC7800CT-ND
D4, D5: BAT54S; SOT-23; Digikey 1727-1868-1-ND
R11: 100; R_1206_3216Metric_Pad1.30x1.75mm_HandSolder; LCSC C137392
R18, R19: 10; R_1206_3216Metric_Pad1.30x1.75mm_HandSolder; LCSC C108080
U10: FT232breakout; ft232rl_breakout_combined_flipped

Connections:
+5V: U10.15 (VCC); also elsewhere on the board
/CONTROLLER/DTR: U10.8 (DTR); also elsewhere on the board
/CONTROLLER/RTS: D5.3 (common), R19.2; also elsewhere on the board
/CONTROLLER/RXD: D4.3 (common), R18.2; also elsewhere on the board
/ft232/RXD: R11.2; also elsewhere on the board
unnamed: R11.1, U10.5 (RXD)
unnamed: R18.1, U10.9 (TXD)
unnamed: R19.1, U10.7 (RTS)

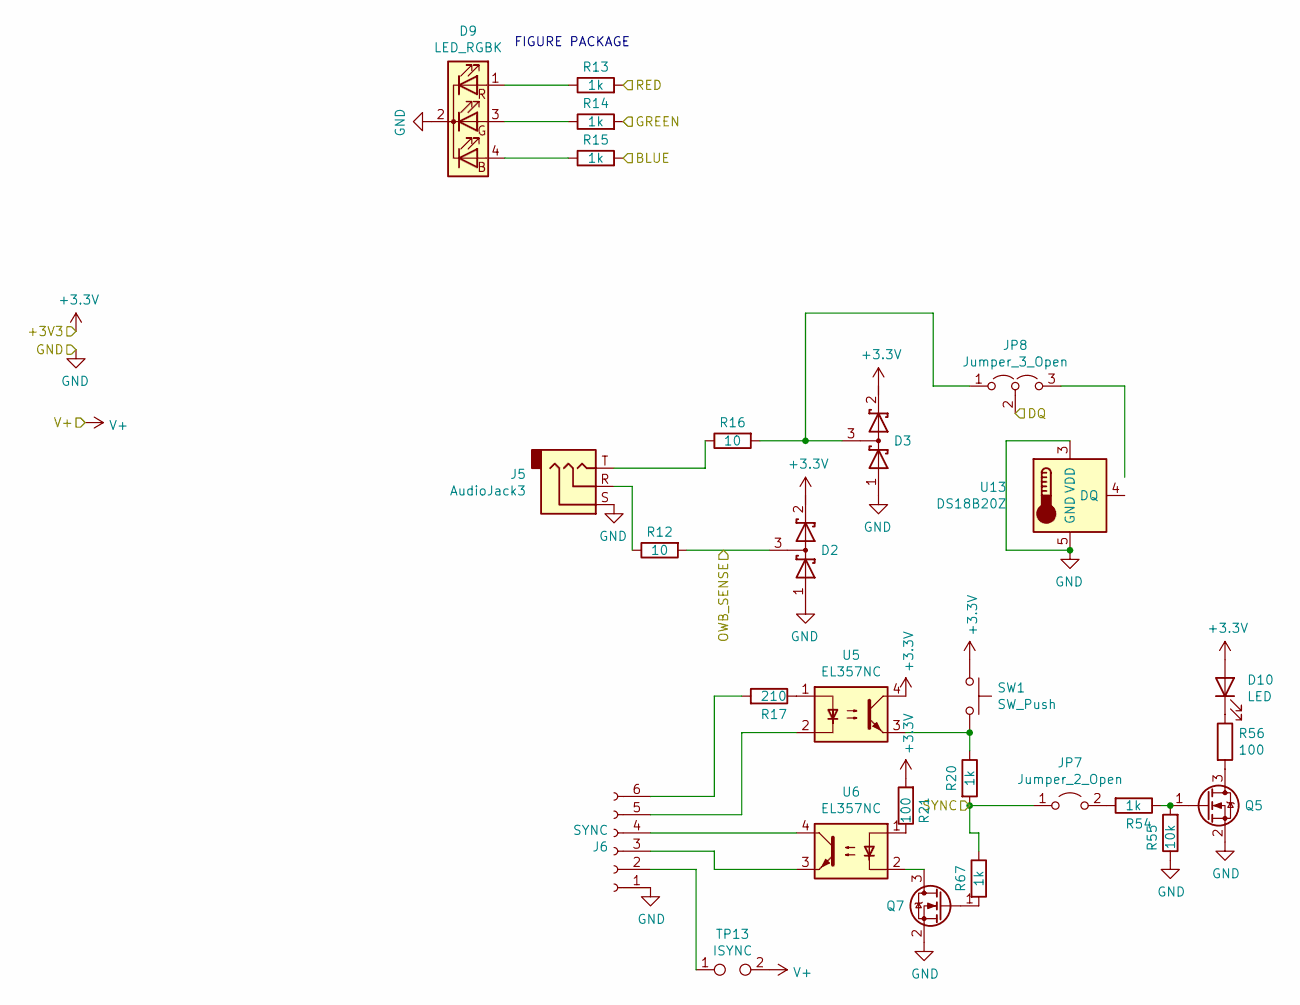
[picture p13: schematic connectors.kicad_sch]

Parts:
D2, D3: BAT54S; SOT-23; Digikey 1727-1868-1-ND
D9: LED_RGBK; LED_D5.0mm-4_RGB; LCSC C330759
D10: LED; LED_1206_3216Metric_Pad1.42x1.75mm_HandSolder; Digikey 732-4989-1-ND
J5: AudioJack3; 3.5mm_audio_PJ-3126-C; Digikey CP1-3523N-ND
J6: SYNC; TerminalBlock_Phoenix_MKDS-1,5-6_1x06_P5.00mm_Horizontal; LCSC C8379
JP7: Jumper_2_Open; PinHeader_1x02_P2.54mm_Vertical
JP8: Jumper_3_Open; PinHeader_1x03_P2.54mm_Vertical
Q5, Q7: BSS806NE; SOT-23; LCSC C91714
R12, R16: 10; R_1206_3216Metric_Pad1.30x1.75mm_HandSolder; LCSC C108080
R13, R14, R15, R20, R54, R67: 1k; R_1206_3216Metric_Pad1.30x1.75mm_HandSolder; LCSC C131398
R17: 210; R_1206_3216Metric_Pad1.30x1.75mm_HandSolder; LCSC C488733
R21, R56: 100; R_1206_3216Metric_Pad1.30x1.75mm_HandSolder; LCSC C137392
R55: 10k; R_1206_3216Metric_Pad1.30x1.75mm_HandSolder; LCSC C132649
SW1: SW_Push; SW_PUSH_6mm_H8mm; LCSC C294505
TP13: ISYNC; PinHeader_1x02_P2.54mm_Vertical
U5, U6: EL357NC; EL357N; Partnumber EL357N(C)(TA)-VG; Digikey 1080-1601-1-ND
U13: DS18B20Z; SOIC-8_3.9x4.9mm_P1.27mm; LCSC C97190

Connections:
/CONTROLLER/BLUE: R15.2; also elsewhere on the board
/CONTROLLER/DQ: JP8.2 (C); also elsewhere on the board
/CONTROLLER/GREEN: R14.2; also elsewhere on the board
/CONTROLLER/OWB_SENSE: D2.3 (common), R12.2; also elsewhere on the board
/CONTROLLER/RED: R13.2; also elsewhere on the board
/CONTROLLER/SYNC: JP7.1 (A), R20.2, R67.1; also elsewhere on the board
unnamed: D3.3 (common), JP8.1 (A), R16.2
unnamed: D9.1 (RA), R13.1
unnamed: D9.3 (GA), R14.1
unnamed: D9.4 (BA), R15.1
unnamed: D10.1 (K), R56.1
unnamed: J5.R, R12.1
unnamed: J5.T, R16.1
unnamed: J6.2, TP13.1
unnamed: J6.3, U6.3
unnamed: J6.4, U6.4
unnamed: J6.5, U5.2
unnamed: J6.6, R17.2
unnamed: JP7.2 (B), R54.2
unnamed: Q5.1 (G), R54.1, R55.2
unnamed: Q5.3 (D), R56.2
unnamed: Q7.1 (G), R67.2
unnamed: Q7.3 (D), U6.2
unnamed: R17.1, U5.1
unnamed: R20.1, SW1.2, U5.3
unnamed: R21.1, U6.1
V+: TP13.2; also elsewhere on the board

Notes on the sheet:
FIGURE PACKAGE

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
