Knotenpunkt-NBG/forcelog-adc/pcb/pcb_motherboard_dev/pcb_motherboard_dev.kicad_pcb

## KiCad design pcb/pcb_motherboard_dev/pcb_motherboard_dev.kicad_pcb (continued)

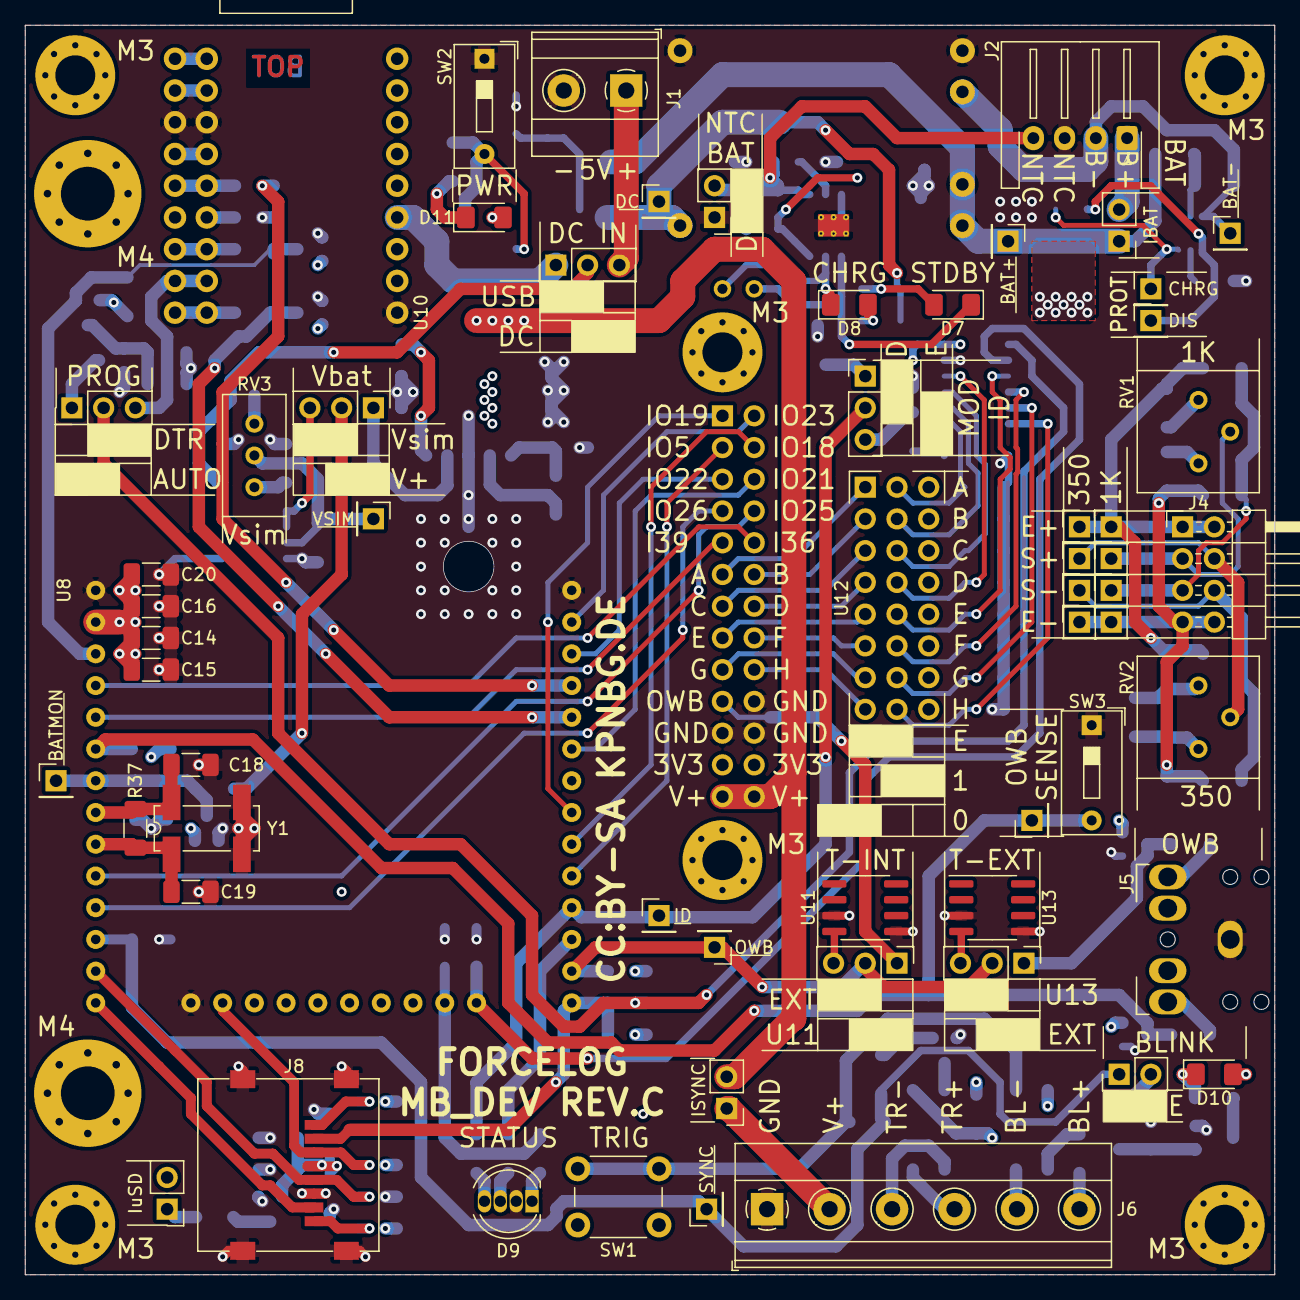
[picture p14: board pcb_motherboard_dev.kicad_pcb from above]

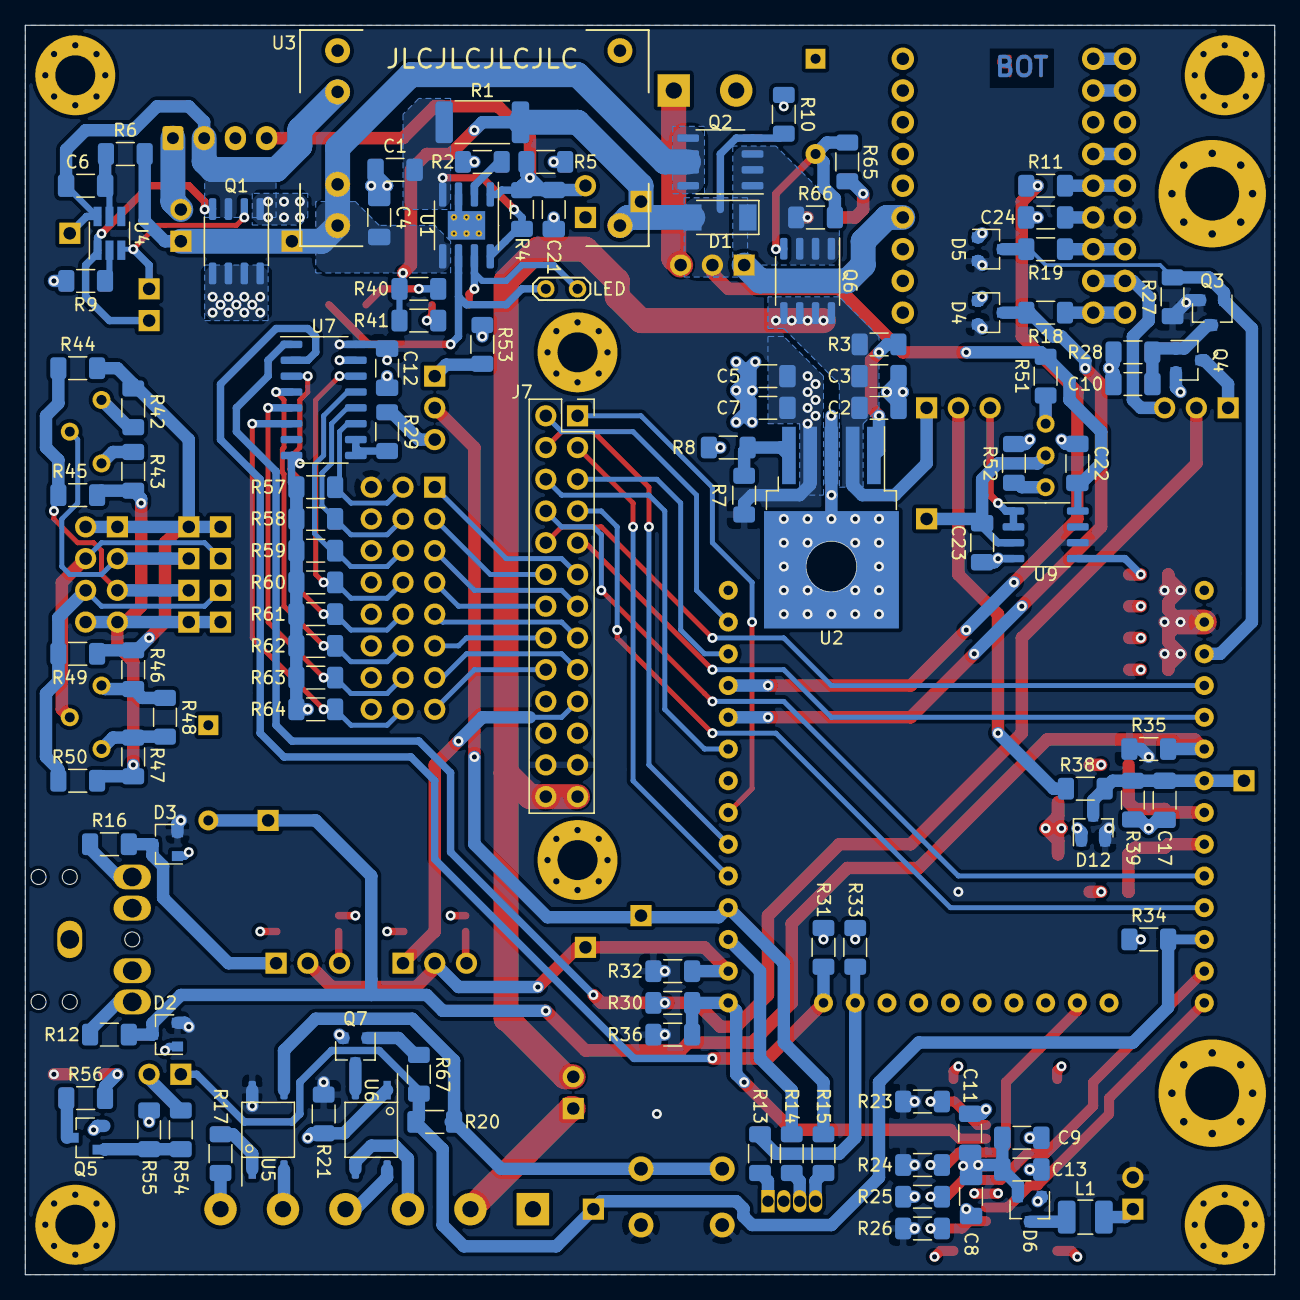
[picture p15: board pcb_motherboard_dev.kicad_pcb from below]

Board: 4 copper layers, 100.0 x 100.0 mm, 176 parts (108 on the bottom side), 122 nets.
