Knotenpunkt-NBG/forcelog-adc/pcb/pcb_motherboard_module/pcb_motherboard_module.kicad_pcb

## KiCad design pcb/pcb_motherboard_module/pcb_motherboard_module.kicad_pcb (2022-08-03)

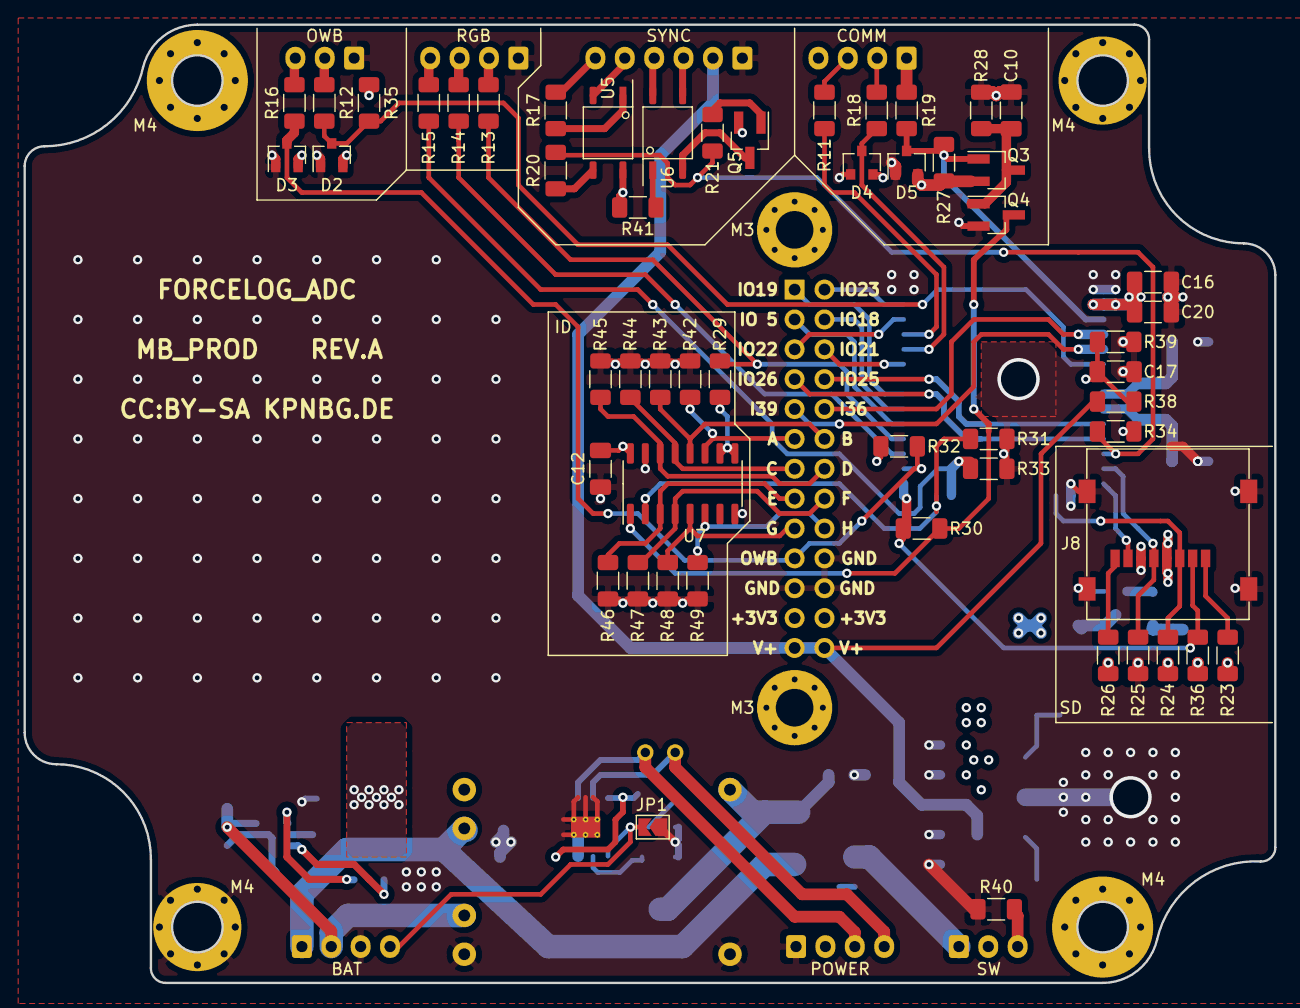
[picture p16: board pcb_motherboard_module.kicad_pcb from above]

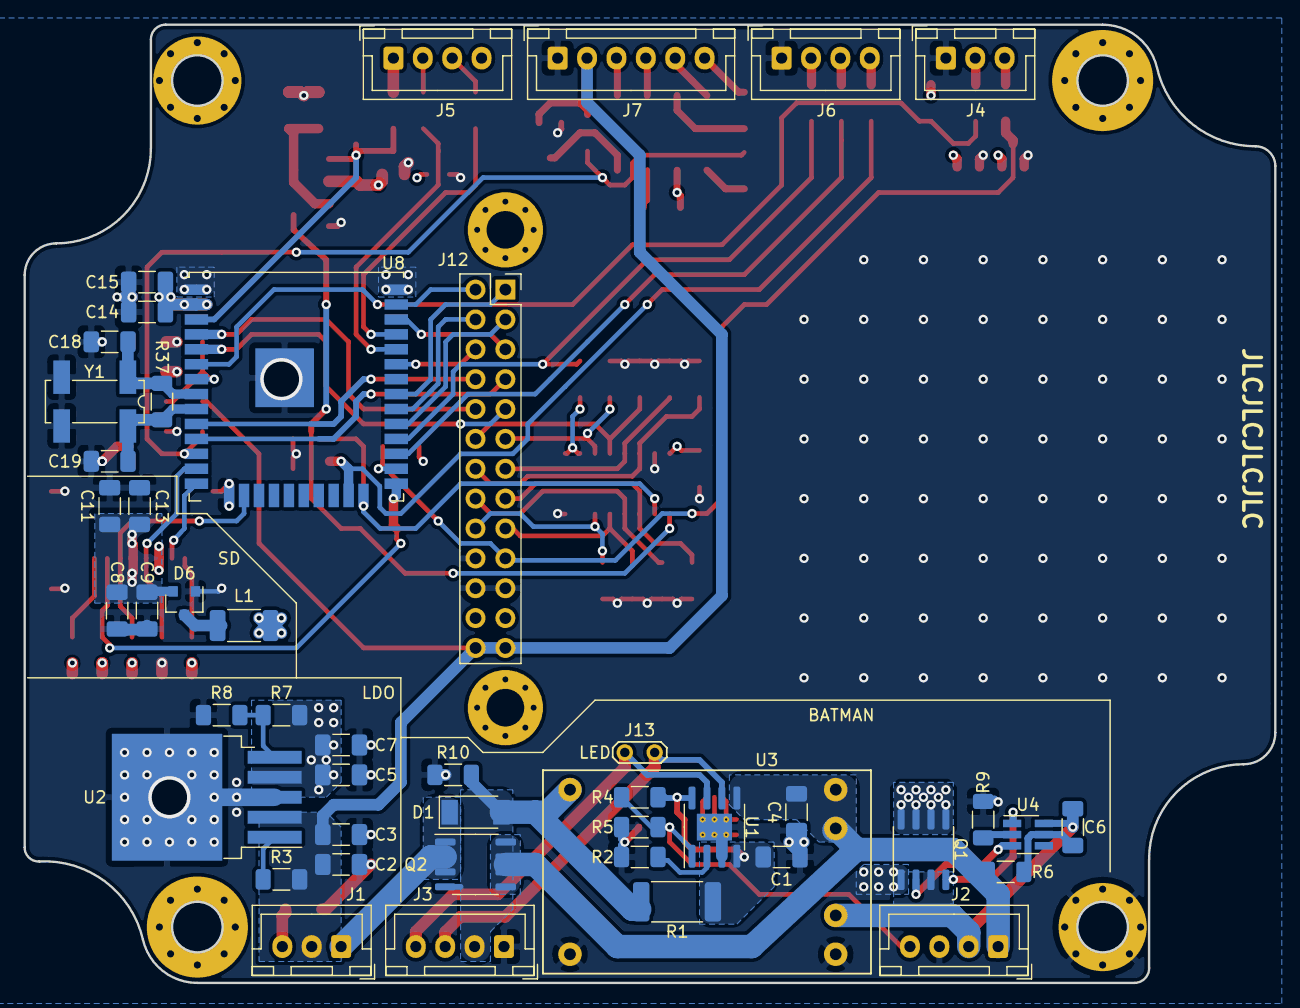
[picture p17: board pcb_motherboard_module.kicad_pcb from below]

Board: 4 copper layers, 106.4 x 81.5 mm, 106 parts (46 on the bottom side), 79 nets.

Parts:
C1, C4: 10u; C_1206_3216Metric_Pad1.33x1.80mm_HandSolder
C2, C6, C7, C8, C12, C14, C17: 100n; C_1206_3216Metric_Pad1.33x1.80mm_HandSolder
C3, C5: 22u; C_1206_3216Metric_Pad1.33x1.80mm_HandSolder
C9, C15: 100u; C_1206_3216Metric_Pad1.33x1.80mm_HandSolder
C10: C; C_1206_3216Metric_Pad1.33x1.80mm_HandSolder
C11, C13, C16, C20: 220u; C_1206_3216Metric_Pad1.33x1.80mm_HandSolder
C18, C19: 25p; C_1206_3216Metric_Pad1.33x1.80mm_HandSolder
D1: PMEG3030EP,115; D_SOD-128
D2, D3, D4, D5, D6: BAT54S; SOT-23
H1, H2, H3: MountingHole; MountingHole_4.3mm_M4_Pad_Via
H4: MountingHole_Pad; MountingHole_4.3mm_M4_Pad_Via
H5, H6: MountingHole_Pad; MountingHole_3.2mm_M3_Pad_Via
J1: SW; JST_XH_B3B-XH-A_1x03_P2.50mm_Vertical
J2: BAT; JST_XH_B4B-XH-A_1x04_P2.50mm_Vertical
J3: POWER; JST_XH_B4B-XH-A_1x04_P2.50mm_Vertical
J4: OWB; JST_XH_B3B-XH-A_1x03_P2.50mm_Vertical
J5: COMM; JST_XH_B4B-XH-A_1x04_P2.50mm_Vertical
J6: RGB; JST_XH_B4B-XH-A_1x04_P2.50mm_Vertical
J7: SYNC; JST_XH_B6B-XH-A_1x06_P2.50mm_Vertical
J8: Micro_SD_Card; uSD_Molex_0472192001
J12: Conn_02x13_Odd_Even; PinSocket_2x13_P2.54mm_Vertical
J13: LED; TestPoint_2Pads_Pitch2.54mm_Drill0.8mm
JP1: Jumper_2_Open; SolderJumper-2_P1.3mm_Open_TrianglePad1.0x1.5mm
L1: 47n; L_2010_5025Metric
Q1: DMG9926USD; SO-8_3.9x4.9mm_P1.27mm
Q2: IRF7410TRPBF; SO8_3.8x4.8_SSSGDDDD
Q3: IRLML2244TRPBF; SOT-23_Handsoldering
Q4, Q5: BSS806NE; SOT-23_Handsoldering
R1: 400m; R_2512_6332Metric_Pad1.40x3.35mm_HandSolder
R2: 1k2; R_1206_3216Metric_Pad1.30x1.75mm_HandSolder
R3, R10, R27, R29, R31, R35, R36, R42, R43, R44, R45, R46, R47, R48, R49: 10k; R_1206_3216Metric_Pad1.30x1.75mm_HandSolder
R4, R5, R28, R40: R; R_1206_3216Metric_Pad1.30x1.75mm_HandSolder
R6: 470; R_1206_3216Metric_Pad1.30x1.75mm_HandSolder
R7: 24k; R_1206_3216Metric_Pad1.30x1.75mm_HandSolder
R8: 5k6; R_1206_3216Metric_Pad1.30x1.75mm_HandSolder
R9, R13, R14, R15, R20, R21, R30, R32: 1k; R_1206_3216Metric_Pad1.30x1.75mm_HandSolder
R11, R41: 100; R_1206_3216Metric_Pad1.30x1.75mm_HandSolder
R12, R16, R18, R19: 10; R_1206_3216Metric_Pad1.30x1.75mm_HandSolder
R17: 210; R_1206_3216Metric_Pad1.30x1.75mm_HandSolder
R23, R24, R25, R26, R34: 22k; R_1206_3216Metric_Pad1.30x1.75mm_HandSolder
R33: 100k; R_1206_3216Metric_Pad1.30x1.75mm_HandSolder
R37: 5Meg; R_1206_3216Metric_Pad1.30x1.75mm_HandSolder
R38: 3k; R_1206_3216Metric_Pad1.30x1.75mm_HandSolder
R39: 7k5; R_1206_3216Metric_Pad1.30x1.75mm_HandSolder
U1: TP4056; SOIC-8-1EP_3.9x4.9mm_P1.27mm_EP2.29x3mm_ThermalVias
U2: LP38501; TO-263-5_TabPin6
U3: TP4056withprotect; TP4056_module_prot
U4: NT1713C; SOT-23-6_Handsoldering
U5, U6: EL357NC; EL357N
U7: 74165; SO-16_3.9x9.9mm_P1.27mm
U8: ESP32-WROOM-32; ESP32-WROOM-32U
Y1: 32.768 kHz; Crystal_SMD_SeikoEpson_MC306-4Pin_8.0x3.2mm_HandSoldering

Connections:
+3V3: C5.1, C7.1, C12.1, C14.1, C15.1, C16.1, C20.1, D2.2, D3.2, D4.2, D5.2, J5.4, J12.23, J12.24, L1.2, Q3.2, R7.1, R23.1, R24.1, R26.1, R27.1, R32.1, R35.1, R36.2, R41.2, U2.4, U5.4, U7.16, U8.2
/CONTROLLER/A: J12.11, R42.2, U7.11
/CONTROLLER/B: J12.12, R43.2, U7.12
/CONTROLLER/BLUE: R13.2, R29.2, U8.28
/CONTROLLER/C: J12.13, R44.2, U7.13
/CONTROLLER/CLK: R31.2, U7.2, U8.24
/CONTROLLER/D: J12.14, R45.2, U7.14
/CONTROLLER/DQ: D3.3, J12.19, R16.2, R32.2, U8.26
/CONTROLLER/DTR: Q4.3, R30.2, U7.1
/CONTROLLER/E: J12.15, R46.2, U7.3
/CONTROLLER/F: J12.16, R47.2, U7.4
/CONTROLLER/G: J12.17, R48.2, U7.5
/CONTROLLER/GREEN: R14.2, U8.27
/CONTROLLER/H: J12.18, R49.2, U7.6
/CONTROLLER/HCLK: J8.5, R25.2, U8.13
/CONTROLLER/HMISO: J8.7, U8.14
/CONTROLLER/HMOSI: J8.3, R24.2, U8.16
/CONTROLLER/HMSS: J8.2, R30.1, R36.1, U8.25
/CONTROLLER/IO_5|V~CS: J12.3, U8.29
/CONTROLLER/IO_18|VCLK: J12.4, U8.30
/CONTROLLER/IO_19|VMISO: J12.1, U8.31
/CONTROLLER/IO_21|SDA: J12.6, U8.33
/CONTROLLER/IO_22|SCL: J12.5, U8.36
/CONTROLLER/IO_23|VMOSI: J12.2, U8.37
/CONTROLLER/IO_25|DAC1: J12.8, U8.10
/CONTROLLER/IO_26|DAC2: J12.7, U8.11
/CONTROLLER/I_36|ADC1_0: J12.10, U8.4
/CONTROLLER/I_39|ADC1_3: J12.9, U8.5
/CONTROLLER/OWB_SENSE: D2.3, R12.2, R35.2, U8.6
/CONTROLLER/RED: R15.2, R33.2, U8.23
/CONTROLLER/RTS: D5.3, Q3.1, R19.2, R27.2, U8.3
/CONTROLLER/RXD: D4.3, R18.2, U8.34
/CONTROLLER/SYNC: R20.1, R21.2, R34.2, U8.12
/CONTROLLER/TXD: R11.2, U8.35
/POWER/BAT+: C4.1, J2.1, Q2.1, R6.2, U1.5, U3.5, U3.6
/POWER/BAT-: C6.2, J2.2, Q1.3, U3.4, U4.6
/POWER/DC_IN: D1.2, J3.2, Q2.2, R1.1, R10.1, U3.1
/POWER/SW: D1.1, J1.1, Q2.3
/POWER/TEMP: J2.4, JP1.2, R4.2, R5.1, U1.1
/POWER/~LED_CHRG: J3.4, J13.1, U1.7
/POWER/~LED_STBY: J3.3, J13.2, U1.6
GND: C1.2, C2.2, C3.2, C4.2, C5.2, C7.2, C8.2, C9.2, C10.2, C11.2, C12.2, C13.2, C14.2, C15.2, C16.2, C17.2, C18.1, C19.2, C20.2, D2.1, D3.1, D4.1, D5.1, D6.1, H4.1, J2.3, J3.1, J4.1, J6.1, J7.1, J8.6, J8.9, J12.20, J12.21, J12.22, JP1.1, Q1.1, Q4.2, Q5.2, R2.2, R5.2, R8.2, R9.2, R10.2, R25.1, R28.2, R31.1, R33.1, R34.1, R39.2, R40.2, R42.1, R43.1, R44.1, R45.1, R46.1, R47.1, R48.1, R49.1, U1.3, U1.9, U2.3, U2.6, U3.2, U3.3, U7.8, U7.15, U8.1, U8.15, U8.38, U8.39, Y1.2, Y1.3
unnamed: C1.1, R1.2, R4.1, U1.4, U1.8
unnamed: C6.1, R6.1, U4.5
unnamed: C10.1, Q3.3, Q4.1, R28.1
unnamed: C8.1, C9.1, C11.1, C13.1, D6.2, J8.4
unnamed: C17.1, R38.2, R39.1, U8.7
unnamed: C18.2, R37.2, U8.8, Y1.1
unnamed: C19.1, R37.1, U8.9, Y1.4
unnamed: D6.3, L1.1
unnamed: J1.3, R40.1
unnamed: J4.2, R12.1
unnamed: J4.3, R16.1
unnamed: J5.1, R19.1
unnamed: J5.2, R18.1
unnamed: J5.3, R11.1
unnamed: J6.2, R13.1
unnamed: J6.3, R14.1
unnamed: J6.4, R15.1
unnamed: J7.3, U6.3
unnamed: J7.4, U6.4
unnamed: J7.5, U5.2
unnamed: J7.6, R17.1
unnamed: J8.1, R23.2
unnamed: J8.8, R26.2
unnamed: Q1.2, U4.3
unnamed: Q1.4, U4.1
unnamed: Q1.5, Q1.6, Q1.7, Q1.8
unnamed: Q5.1, R21.1
unnamed: Q5.3, U6.2
unnamed: R2.1, U1.2
unnamed: R3.1, U2.1
unnamed: R7.2, R8.1, U2.5
unnamed: R9.1, U4.2
unnamed: R17.2, U5.1
unnamed: R20.2, U5.3
unnamed: R29.1, U7.9, U7.10
unnamed: R41.1, U6.1
VDD: C2.1, C3.1, J1.2, J7.2, J12.25, J12.26, R3.2, R38.1, U2.2
