Knotenpunkt-NBG/forcelog-adc/pcb/pcb_module_ads1231-a/pcb_module_ads1231-a.kicad_pcb

## KiCad design pcb/pcb_module_ads1231-a/pcb_module_ads1231-a.kicad_pcb (2022-08-03)

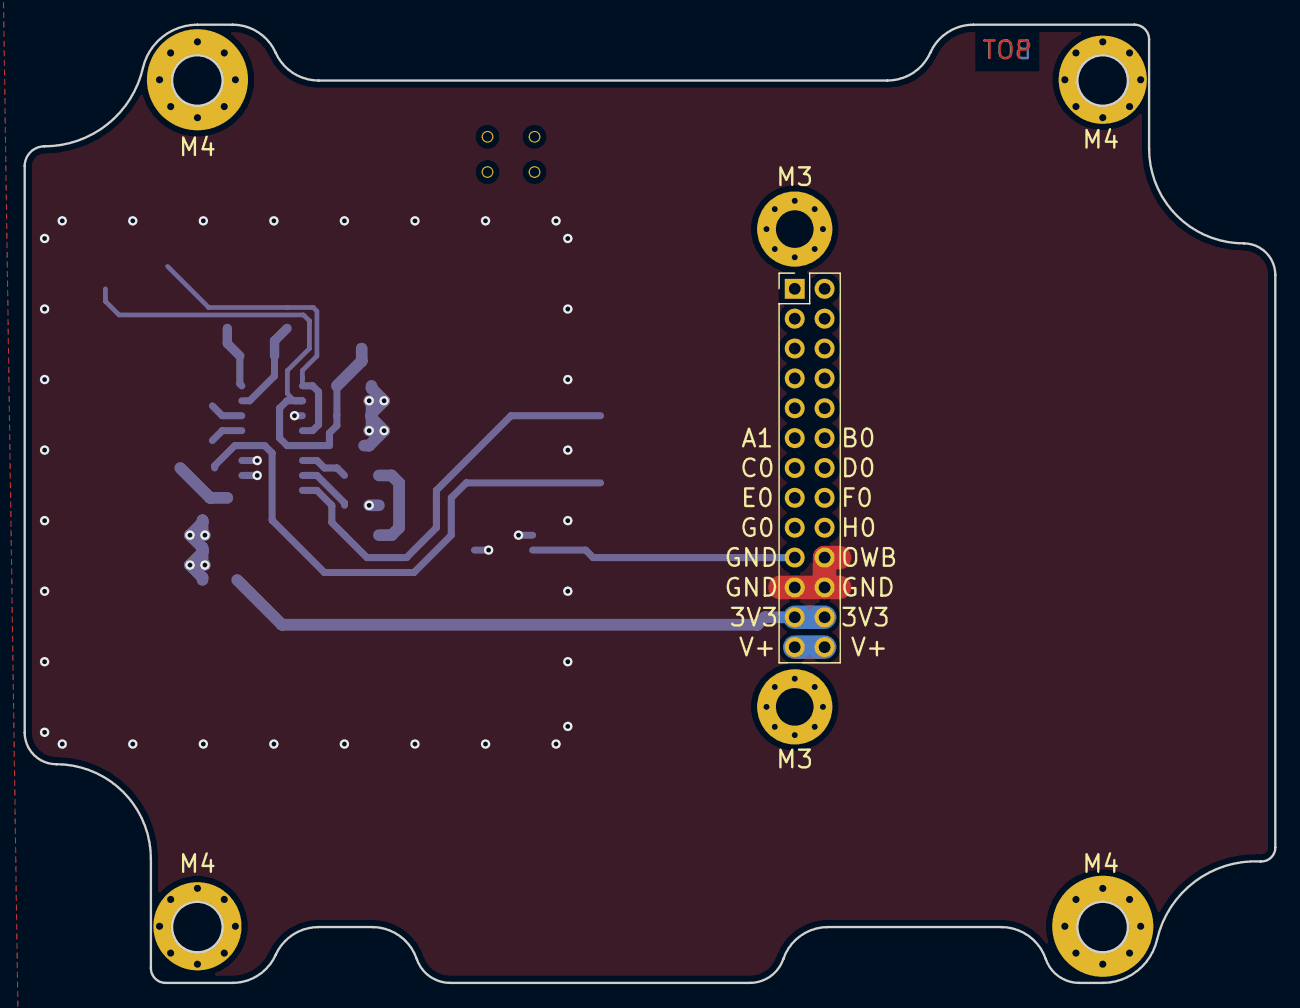
[picture p18: board pcb_module_ads1231-a.kicad_pcb from above]

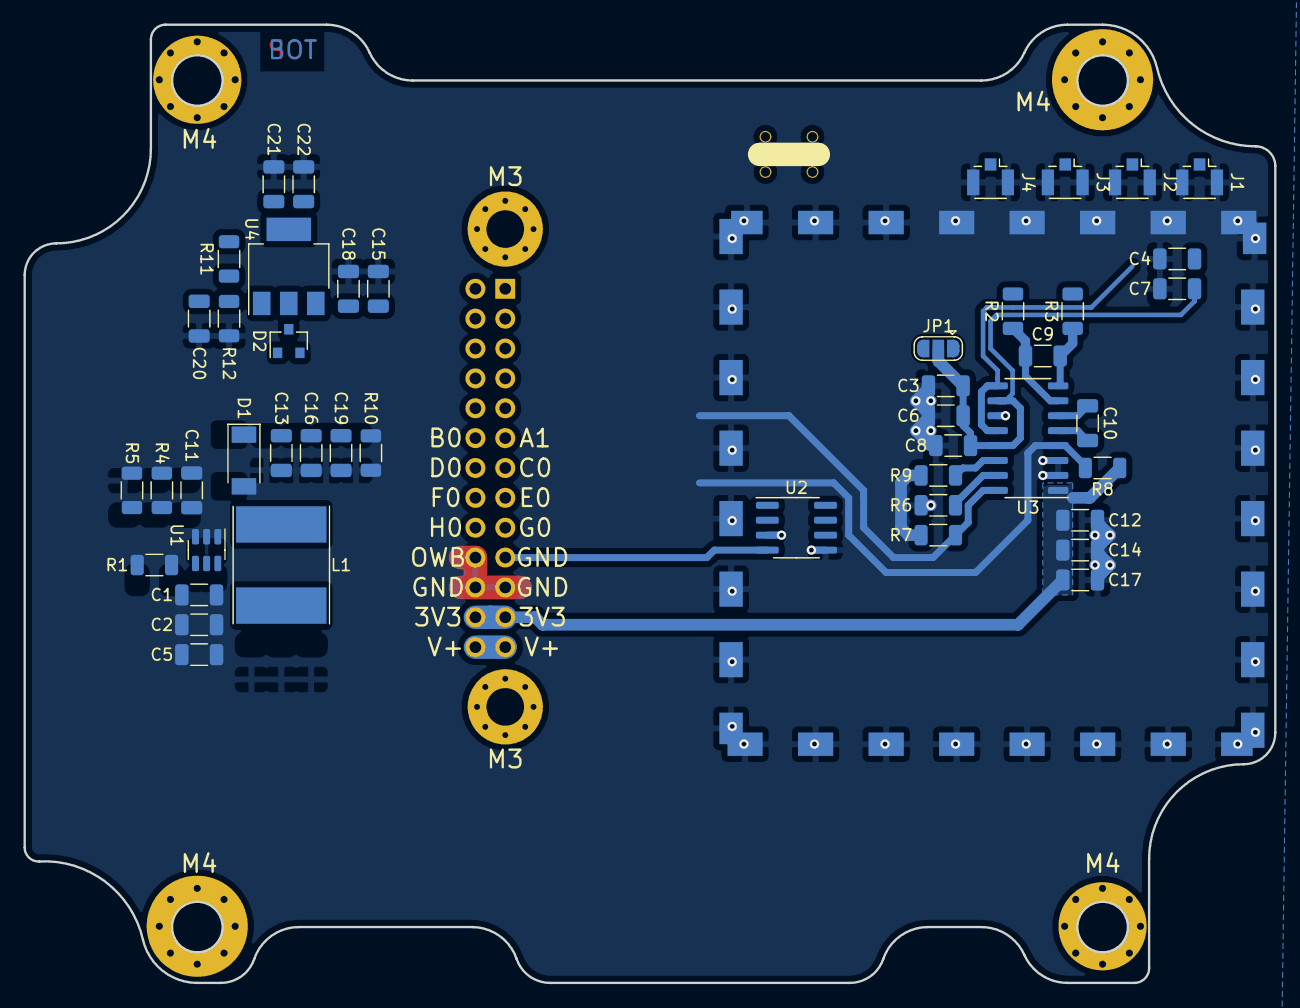
[picture p19: board pcb_module_ads1231-a.kicad_pcb from below]

Board: 2 copper layers, 106.4 x 81.5 mm, 55 parts (48 on the bottom side), 22 nets.

Parts:
C1, C4, C8, C9, C10, C12, C13, C18, C21: 100n; C_1206_3216Metric
C2, C6, C7, C14, C15, C16, C22: 10u; C_1206_3216Metric
C3, C17: 47u; C_1206_3216Metric
C5, C19: 100u; C_1206_3216Metric
C11: 330p; C_1206_3216Metric
C20: 10n; C_1206_3216Metric
D1: PMEG3030EP,115; D_SOD-128
D2: D_Dual_Series_AKC; SOT-23
H1, H2: MountingHole_Pad; MountingHole_3.2mm_M3_Pad_Via
H3: MountingHole; cableclamp_4x1.13_coax_bundled
H4, H5, H6, H7: MountingHole_Pad; MountingHole_4.3mm_M4_Pad_Via
J1, J2, J3, J4: Conn_Coaxial; U.FL_Hirose_U.FL-R-SMT-1_Vertical
J5: RFShield_TwoPieces; Shield_TE2118726-2
J7: Conn_02x13_Odd_Even; PinHeader_2x13_P2.54mm_Vertical
JP1: SolderJumper_3_Open; SolderJumper-3_P1.3mm_Open_RoundedPad1.0x1.5mm
L1: 10u; L_Taiyo-Yuden_NR-80xx_HandSoldering
R1: 51k; R_1206_3216Metric
R2, R3: 100; R_1206_3216Metric
R4: 130k; R_1206_3216Metric
R5: 9k1; R_1206_3216Metric
R6, R7, R8, R9: 10k; R_1206_3216Metric
R10, R12: 1k; R_1206_3216Metric
R11: 330; R_1206_3216Metric
U1: MT3608; SOT-23-6
U2: DS18B20Z; SOIC-8_3.9x4.9mm_P1.27mm
U3: ads1231; SO-16_3.9x9.9mm_P1.27mm
U4: LM317_SOT-223; SOT-223-3_TabPin2

Connections:
+3V3: C12.1, C14.1, C17.1, J7.23, J7.24, JP1.3, R7.1, R8.1, R9.1, U3.1
+5VA: C21.1, C22.1, D2.3, JP1.1, R11.1, U4.2
+9V: C11.1, C13.1, C15.1, C16.1, C18.1, C19.1, D1.1, D2.2, R4.1, R10.1, U4.3
/DOUT: J7.1, R7.2, U3.16
/DQ: J7.19, U2.4
/E+: C3.1, C4.1, C6.1, C7.1, C8.1, J1.1, JP1.2, U3.10, U3.13
/E-: J2.1, U3.9, U3.12
/EN: R1.2, U1.4
/PDWN: J7.8, R9.2, U3.14
/S+: J4.1, R2.2
/S-: J3.1, R3.2
/SCLK: J7.4, R6.2, U3.15
/SPEED: J7.6, R8.2, U3.4
GND: C1.2, C2.2, C3.2, C4.2, C5.2, C6.2, C7.2, C8.2, C12.2, C13.2, C14.2, C15.2, C16.2, C17.2, C18.2, C19.2, C20.2, C21.2, C22.2, J1.2, J2.2, J3.2, J4.2, J5.1, J7.20, J7.21, J7.22, R5.2, R6.1, R10.2, R12.2, U1.2, U2.3, U2.5, U3.2, U3.3, U3.11
unnamed: C9.1, R2.1, U3.7
unnamed: C9.2, R3.1, U3.8
unnamed: C10.1, U3.5
unnamed: C10.2, U3.6
unnamed: C11.2, R4.2, R5.1, U1.3
unnamed: C20.1, D2.1, R11.2, R12.1, U4.1
unnamed: D1.2, L1.2, U1.1
V+: C1.1, C2.1, C5.1, J7.25, J7.26, L1.1, R1.1, U1.5
