Knotenpunkt-NBG/forcelog-adc/pcb/pcb_module_hx711/pcb_module_hx711.kicad_pcb

## KiCad design pcb/pcb_module_hx711/pcb_module_hx711.kicad_pcb (2022-08-03)

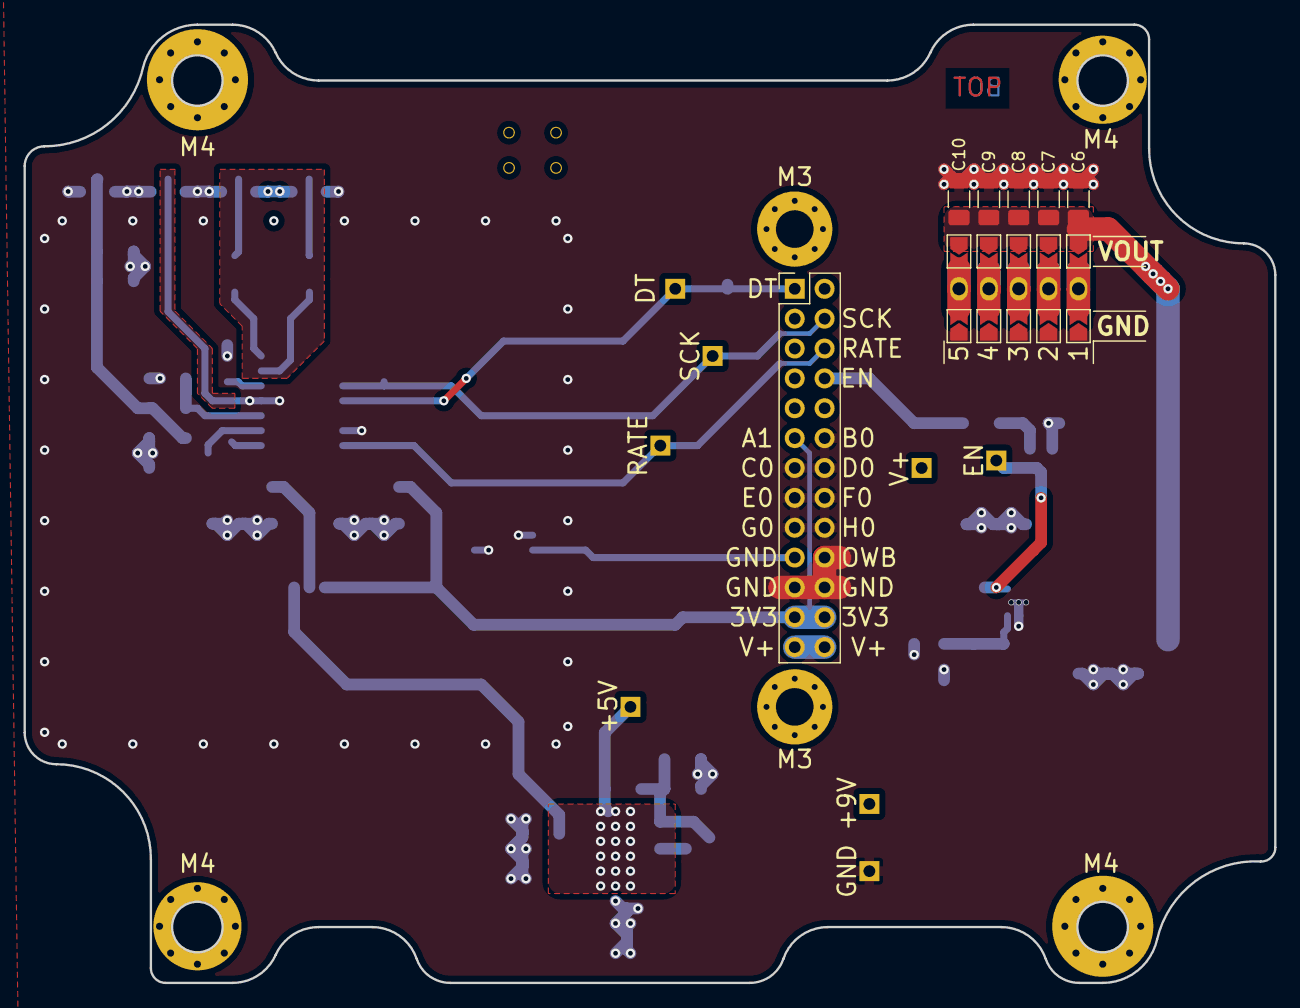
[picture p20: board pcb_module_hx711.kicad_pcb from above]

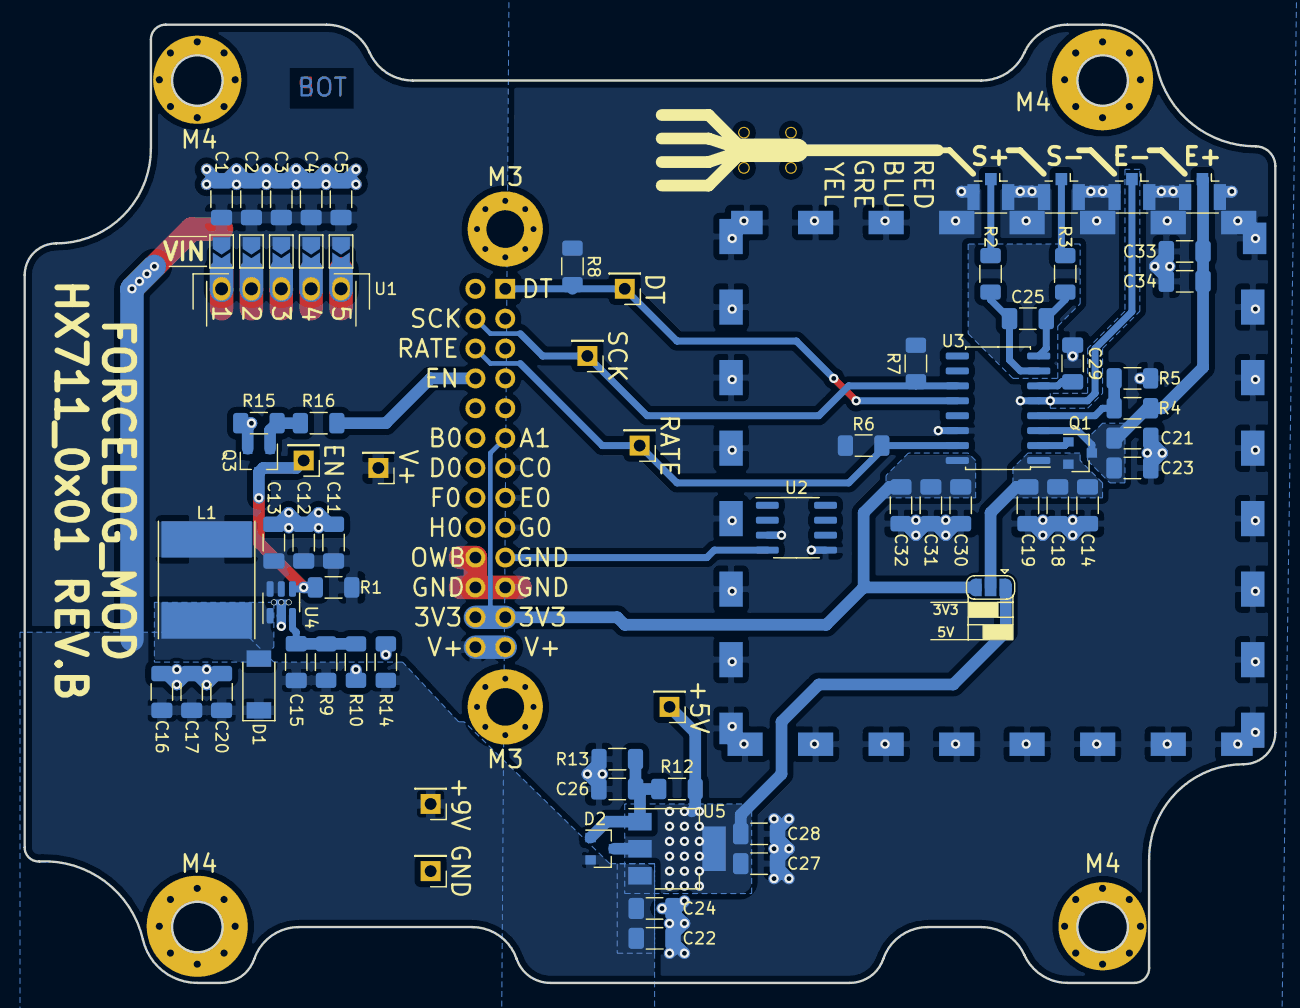
[picture p21: board pcb_module_hx711.kicad_pcb from below]

Board: 2 copper layers, 106.4 x 81.5 mm, 96 parts (74 on the bottom side), 29 nets.

Parts:
C1, C2, C3, C4, C5, C6, C7, C8, C9, C10, C12, C17, C18, C22, C23, C26, C28, C31, C34: 10u; C_1206_3216Metric_Pad1.33x1.80mm_HandSolder
C11, C16: 100u; C_1206_3216Metric_Pad1.33x1.80mm_HandSolder
C13, C19, C20, C21, C24, C25, C27, C29, C30, C33: 100n; C_1206_3216Metric_Pad1.33x1.80mm_HandSolder
C14, C32: 47u; C_1206_3216Metric_Pad1.33x1.80mm_HandSolder
C15: 330p; C_1206_3216Metric_Pad1.33x1.80mm_HandSolder
D1: D_Schottky; D_SOD-128
D2: BAT54S; SOT-23
H1, H2: MountingHole_Pad; MountingHole_3.2mm_M3_Pad_Via
H3: MountingHole; cableclamp_4x1.13_coax_bundled
H4, H5, H6, H7: MountingHole_Pad; MountingHole_4.3mm_M4_Pad_Via
J1: E+; U.FL_Hirose_U.FL-R-SMT-1_Vertical
J2: E-; U.FL_Hirose_U.FL-R-SMT-1_Vertical
J3: S+; U.FL_Hirose_U.FL-R-SMT-1_Vertical
J4: S-; U.FL_Hirose_U.FL-R-SMT-1_Vertical
J5: RFShield_TwoPieces; Shield_TE2118726-2
J7: Conn_02x13_Odd_Even; PinHeader_2x13_P2.54mm_Vertical
JP1, JP2, JP3, JP4, JP5, JP6, JP7, JP8, JP9, JP10, JP11, JP12, JP13, JP14, JP15: Jumper_2_Open; SolderJumper-2_P1.3mm_Open_TrianglePad1.0x1.5mm
JP16: Jumper_3_Open; SolderJumper-3_P1.3mm_Open_RoundedPad1.0x1.5mm
L1: 10; L_Taiyo-Yuden_NR-80xx_HandSoldering
Q1: MMBT4403L; SOT-23
Q3: BSS806NE; SOT-23
R1: 51k; R_1206_3216Metric_Pad1.30x1.75mm_HandSolder
R2, R3: 100; R_1206_3216Metric_Pad1.30x1.75mm_HandSolder
R4: 20k; R_1206_3216Metric_Pad1.30x1.75mm_HandSolder
R5: 7k15; R_1206_3216Metric_Pad1.30x1.75mm_HandSolder
R6, R7, R8, R15: 10k; R_1206_3216Metric_Pad1.30x1.75mm_HandSolder
R9: 130k; R_1206_3216Metric_Pad1.30x1.75mm_HandSolder
R10: 9k1; R_1206_3216Metric_Pad1.30x1.75mm_HandSolder
R12: 330; R_1206_3216Metric_Pad1.30x1.75mm_HandSolder
R13, R14: 1k; R_1206_3216Metric_Pad1.30x1.75mm_HandSolder
R16: 220; R_1206_3216Metric_Pad1.30x1.75mm_HandSolder
TP1, TP2: GND; PinHeader_1x01_P2.54mm_Vertical
TP3: SCK; PinHeader_1x01_P2.54mm_Vertical
TP4: DT; PinHeader_1x01_P2.54mm_Vertical
TP5: RATE; PinHeader_1x01_P2.54mm_Vertical
TP6: +9V; PinHeader_1x01_P2.54mm_Vertical
TP7: +5V; PinHeader_1x01_P2.54mm_Vertical
TP8: TP; PinHeader_1x01_P2.54mm_Vertical
U1: BOOST MODULE; boost_generic_var
U2: DS18B20Z; SOIC-8_3.9x4.9mm_P1.27mm
U3: HX711; SO-16_5.3x10.2mm_P1.27mm
U4: MT3608; SOT-23-6
U5: LM317_SOT-223; SOT-223-3_TabPin2

Connections:
+3V3: C30.1, C31.1, C32.1, J7.11, J7.23, J7.24, JP16.3, U3.16
+5VA: C27.1, C28.1, D2.3, JP16.1, R12.1, TP7.1, U5.2
+9V: C6.2, C7.2, C8.2, C9.2, C10.2, C15.1, C16.1, C17.1, C20.1, C22.1, C24.1, D1.1, D2.2, JP11.1, JP12.1, JP13.1, JP14.1, JP15.1, R9.1, R14.1, TP6.1, U5.3
/BOOST_PIN1: JP1.2, JP6.2, JP11.2, U1.1
/BOOST_PIN2: JP2.2, JP7.2, JP12.2, U1.2
/BOOST_PIN3: JP3.2, JP8.2, JP13.2, U1.3
/BOOST_PIN4: JP4.2, JP9.2, JP14.2, U1.4
/BOOST_PIN5: JP5.2, JP10.2, JP15.2, U1.5
/DQ: J7.19, U2.4
/DT: J7.1, R8.2, TP4.1, U3.12
/EN: Q3.3, R1.2, TP8.1, U4.4
/RATE: J7.6, R6.2, TP5.1, U3.15
/SCK: J7.4, R7.2, TP3.1, U3.11
GND: C1.1, C2.1, C3.1, C4.1, C5.1, C6.1, C7.1, C8.1, C9.1, C10.1, C11.2, C12.2, C13.2, C14.2, C16.2, C17.2, C18.2, C19.2, C20.2, C21.2, C22.2, C23.2, C24.2, C26.2, C27.2, C28.2, C29.2, C30.2, C31.2, C32.2, C33.2, C34.2, J1.2, J2.2, J3.2, J4.2, J5.1, J7.12, J7.13, J7.14, J7.15, J7.16, J7.17, J7.18, J7.20, J7.21, J7.22, JP6.1, JP7.1, JP8.1, JP9.1, JP10.1, Q3.2, R5.2, R6.1, R7.1, R8.1, R10.2, R13.2, R14.2, R15.2, TP2.1, U2.3, U2.5, U3.5, U3.14, U4.2
unnamed: C14.1, C18.1, C19.1, JP16.2, Q1.2, U3.1
unnamed: C15.2, R9.2, R10.1, U4.3
unnamed: C21.1, C23.1, C33.1, C34.1, J1.1, Q1.3, R4.1, U3.3
unnamed: C25.1, R2.2, U3.7
unnamed: C25.2, R3.2, U3.8
unnamed: C26.1, D2.1, R12.2, R13.1, U5.1
unnamed: C29.1, U3.6
unnamed: D1.2, L1.2, U4.1
unnamed: J3.1, R3.1
unnamed: J4.1, R2.1
unnamed: J7.8, R16.2
unnamed: Q1.1, U3.2
unnamed: Q3.1, R15.1, R16.1
unnamed: R4.2, R5.1, U3.4
V+: C1.2, C2.2, C3.2, C4.2, C5.2, C11.1, C12.1, C13.1, J7.25, J7.26, JP1.1, JP2.1, JP3.1, JP4.1, JP5.1, L1.1, R1.1, TP1.1, U4.5, U4.6
