Knotenpunkt-NBG/forcelog-adc/firmware_forcelogADC/main/main.c

#include "main.h"

struct stu_initConfig* gstu_config;

struct stu_adcConfig*		pstu_adcConfig;
struct stu_sensorConfig*	pstu_sensorConfig;
struct stu_blinkConfig*		pstu_blinkConfig;
struct stu_triggerConfig*	pstu_triggerConfig;
struct stu_apConfig*		pstu_hotspotConfig;
struct stu_batmonConfig* 	pstu_batMonConfig;
struct stu_tempConfig*		pstu_tempConfig;
struct stu_staConfig*		pstu_staConfigMom;
struct stu_staConfig*		pstu_staConfig;

//Event groups
EventGroupHandle_t eg_wifi;
EventGroupHandle_t eg_sync;
EventGroupHandle_t eg_config;
EventGroupHandle_t eg_status;


//Queues
QueueHandle_t q_send;
QueueHandle_t q_recv;
QueueHandle_t q_rgb_status;
QueueHandle_t q_tcpMessages;
QueueHandle_t q_uartMessages;
QueueHandle_t q_pconfigIn;
QueueHandle_t q_pconfigOut;

QueueHandle_t q_measurements;
QueueHandle_t q_measurements_redund;


//Semaphores
SemaphoreHandle_t hs_oneWire;
SemaphoreHandle_t hs_pointerQueue;
SemaphoreHandle_t hs_configCom;


//Timers
esp_timer_handle_t 	htim_periodicAdc;
TimerHandle_t 		h_timerBlink;
TimerHandle_t 		h_timerBatMon;
TimerHandle_t		htim_tcpSend;
TimerHandle_t		htim_oneWire;
TimerHandle_t		htim_staTimeOut;


//Tasks Handles
TaskHandle_t ht_blinkRun;
TaskHandle_t ht_tcpMes;
TaskHandle_t ht_tcpConf;
TaskHandle_t ht_udpWait;
TaskHandle_t ht_adcRun;
TaskHandle_t ht_storageRun;
TaskHandle_t ht_wifiRun;
TaskHandle_t ht_batmonRun;
TaskHandle_t ht_serialRun;
TaskHandle_t ht_tempIntRun;
TaskHandle_t ht_tempExtRun;
TaskHandle_t ht_configRun;
TaskHandle_t ht_wifiBroadcast;

//General Handles
esp_netif_t* h_netif;

void app_main()
{
	uint8_t gb_moduleID;
	esp_log_level_set("*", ESP_LOG_ERROR);
	fsetLogLevel(LOG_DEBUG);

	pstu_adcConfig = malloc(sizeof(struct stu_adcConfig));
	pstu_sensorConfig = malloc(sizeof(struct stu_sensorConfig));
	pstu_blinkConfig = malloc(sizeof(struct stu_blinkConfig));
	pstu_triggerConfig = malloc(sizeof(struct stu_triggerConfig));
	pstu_hotspotConfig = malloc(sizeof(struct stu_apConfig));
	pstu_batMonConfig = malloc(sizeof(struct stu_batmonConfig));
	pstu_tempConfig = malloc(sizeof(struct stu_tempConfig));
	pstu_staConfigMom = malloc(sizeof(struct stu_staConfig));
	pstu_staConfig = malloc(sizeof(struct stu_staConfig));

	h_netif = 0;
	ht_wifiBroadcast = 0;

	//Creating Semaphores
	hs_configCom = xSemaphoreCreateBinary();
	xSemaphoreGive(hs_configCom);
	hs_pointerQueue = xSemaphoreCreateBinary();
	xSemaphoreGive(hs_pointerQueue);
	hs_oneWire = xSemaphoreCreateBinary();
	xSemaphoreGive(hs_oneWire);

	//Creating Event Groups
	eg_sync		= xEventGroupCreate();
	eg_config	= xEventGroupCreate();
	eg_status	= xEventGroupCreate();



	//Creating queues q_time_temp
	q_rgb_status 		=	xQueueCreate(	10, sizeof(uint32_t));
	q_tcpMessages		=	xQueueCreate(	10,	sizeof(char *));
	q_uartMessages		=	xQueueCreate(	10,	sizeof(char *));
	q_send				=	xQueueCreate(	1,	sizeof(void *));
	q_recv				=	xQueueCreate(	1,	sizeof(void *));
	q_pconfigIn			=	xQueueCreate(	5,	sizeof(void *));
	q_pconfigOut		=	xQueueCreate(	5,	sizeof(stu_configMessage));

	q_measurements			=	xQueueCreate(	50,	sizeof(stu_mesCell));
	q_measurements_redund	=	xQueueCreate(	50,	sizeof(stu_mesCell));


	//CHECKING FOR MODULE ID
	gb_moduleID = fcheckModuleId();


	//STARTING BASIC TASKS FOR INITALISING
	xTaskCreate(status_led,		"status_led",		2048, NULL, 10, NULL);
	fstorageInit();
	fserialInit();

	while(xTaskNotify(ht_storageRun,CMD_init,eSetValueWithoutOverwrite) != pdPASS)
		vTaskDelay(1/ portTICK_PERIOD_MS);
	xEventGroupSync( eg_sync,
			BIT_CONFIG_SYNC ,
			BIT_CONFIG_SYNC | BIT_STORAGE_SYNC,
			portMAX_DELAY );


	//STARTING OTHER TASKS
	fWifiInit();
	ftcpInit();
	fblinkInit();
	fbatMonInit();
	ftempIntInit();
	if (gb_moduleID == MODULE_ID)
	{
		ESP_LOGE(TAG_CONF, "MODULE FOUND STARTING %s", MODULE_NAME);
		fADCInit();
	}
	else
	{
		ESP_LOGE(TAG_CONF, "ADC MODULE MISMATCH! MODULE ID(0x%02X) for %s does not equal Firmware(0x%02X)\n", gb_moduleID, MODULE_NAME, MODULE_ID);
		while(1)
		{
			//TODO:Set tatus LED to Module not Found
			vTaskDelay(100);
		}

	}
	fconfigInit();

	vTaskDelete(NULL);
}

// Gets the Module ID
uint8_t fcheckModuleId ()
{
	gpio_config_t io_conf;
	io_conf.intr_type = GPIO_INTR_DISABLE;
	io_conf.mode = GPIO_MODE_INPUT;
	io_conf.pin_bit_mask = (1ULL<<PIN_MODULE_ID_DOUT);
	io_conf.pull_down_en = 0;
	io_conf.pull_up_en = 0;
	gpio_config(&io_conf);

	io_conf.intr_type = GPIO_INTR_DISABLE;
	io_conf.mode = GPIO_MODE_OUTPUT;
	io_conf.pin_bit_mask = ((1ULL<<PIN_MODULE_ID_SELECT) | (1ULL<<PIN_MODULE_ID_CLK));
	io_conf.pull_down_en = 0;
	io_conf.pull_up_en = 0;
	gpio_config(&io_conf);

	uint8_t b_moduleId = 0;
	gpio_set_level(PIN_MODULE_ID_CLK, 0);
	gpio_set_level(PIN_MODULE_ID_SELECT, 1);
	vTaskDelay(1 / portTICK_PERIOD_MS);
	gpio_set_level(PIN_MODULE_ID_SELECT, 0);
	vTaskDelay(1 / portTICK_PERIOD_MS);
	gpio_set_level(PIN_MODULE_ID_SELECT, 1);
	vTaskDelay(1 / portTICK_PERIOD_MS);
	for (int i = 0; i<8; i++)
	{
		vTaskDelay(1 / portTICK_PERIOD_MS);
		b_moduleId |= (gpio_get_level(PIN_MODULE_ID_DOUT) << (7 - i));
		gpio_set_level(PIN_MODULE_ID_CLK, 1);
		vTaskDelay(1/ portTICK_PERIOD_MS);
		gpio_set_level(PIN_MODULE_ID_CLK, 0);
	}
	return b_moduleId;
}
