Knotenpunkt-NBG/forcelog-adc/firmware_forcelogADC/main/com_tcp.h

/*
 * tcp_client.h
 *
 *  Created on: Apr 18, 2020
 *      Author: lor
 */

#ifndef MAIN_COM_TCP_H_
#define MAIN_COM_TCP_H_

#include "freertos/FreeRTOS.h"
#include "freertos/task.h"
#include "freertos/queue.h"
#include "freertos/event_groups.h"
#include "esp_system.h"
#include <lwip/sockets.h>
#include "esp_wifi.h"
#include <esp_event.h>
#include "driver/uart.h"
#include "freertos/semphr.h"

#include "defines.h"
#include "globals.h"
#include "config.h"





void ftcpInit();
//Reads string from tcp socket
//RETURN:
//1 if string has been read
//0 if no string has been found
//-1 if string has been found but without delimiter (\n, \0 or \r)
int		freadTcpString	(char* out, int i_maxNumChars, int sock);
void	fsendAck		(int sock);
int		fsendKeepAlive	(int sock);
int		fconnSock		(in_port_t* port);
void 	fconfigTcp		(uint32_t ui_cmdlet,
						int* sock);

uint32_t	fgetMessage		(int sock,
							char* pc_configIn,
							uint32_t ui_timeout);

uint32_t	fsendMessage	(int sock,
							char* pc_configOut);
void	ttcpMes			(void* param);
void	ttcpConf		(void* param);

void	callback_buffer	(void* param);

#endif /* MAIN_COM_TCP_H_ */
