Knotenpunkt-NBG/forcelog-adc/firmware_forcelogADC/main/storage.h

/*
 * local_storage.h
 *
 *  Created on: Oct 25, 2020
 *      Author: lor
 */

#ifndef MAIN_STORAGE_H_
#define MAIN_STORAGE_H_

#include <stdio.h>
#include <string.h>
#include <sys/unistd.h>
#include <sys/stat.h>
#include "esp_err.h"
#include "esp_log.h"
#include "freertos/FreeRTOS.h"
#include "freertos/task.h"

#include "esp_wifi.h"
#include <lwip/sockets.h>

#include "vfs_fat_internal.h"
#include "diskio_impl.h"
#include "diskio_sdmmc.h"
#include "sdmmc_cmd.h"
#include "esp_vfs.h"
#include "esp_vfs_fat.h"
#include "driver/sdmmc_host.h"
#include "driver/sdspi_host.h"
#include "sdmmc_cmd.h"
//#include "owb.h"
#include "dirent.h"

#include "globals.h"
#include "aux.h"

#define MOUNT_POINT "/sdcard"
#define USE_SPI_MODE
#define SPI_DMA_CHAN    1

#define PIN_NUM_MISO 12
#define PIN_NUM_MOSI 13
#define PIN_NUM_CLK  14
#define PIN_NUM_CS   0
#define allocation_unit_size	(16 * 1024)
#define max_files	2

void			fstorageInit	(void);

void			tstorageRun		(void* param);

void			fsdConfig		(uint32_t ui_cmdlet);

esp_err_t		fFormatSD		();

uint32_t		fwriteInit		(void);

uint32_t		ffileList		(char* pc_fileName,
								char* pc_configOut);
char*			floadInit		();




#endif /* MAIN_STORAGE_H_ */
