Knotenpunkt-NBG/forcelog-adc/(commit log)

2020-10-06 Update
    -renamed uart to serial
    -fixed wifi
    [blink.c, blink.h, config.c, config.h, defines.h, globals.h, main.c, main.h]
2020-10-26 Coded again
    -added 1-wire component and support for internal temperature probe
    -added support for sd card for backup storage if connection is lost
    -refactored config so both interfaces (tcp and uart) can accept the same cmdlets
    -added battery voltage sensing
    [styleguide.ods]
2020-11-03 Coded again
    -changed event groups to direct to task notifications for speed
    -added SD-card support for config files
    -reworked the flow of the running tasks so the code looks cleaner
    [batmon.c, batmon.h, blink.c, blink.h, com_serial.c, com_serial.h, com_tcp.c, com_tcp.h]
2020-11-03 removed cad
    [1550Z113 Assembly.stp, 18650 Battery Holder.STEP, 4250012.igs, 425004.igs, HG2400RDR-RSP.step, LED 5mm.IGS, MMCX male to SMA female.step, RND 455-00370_3D.STEP]
2020-11-23 Cleaned up Config
    -added init routine
    -fixed bug between comm and config
    -added granular storage
    [batmon.c, batmon.h, blink.c, blink.h, com_serial.c, com_serial.h, com_tcp.c, com_tcp.h]
2021-02-28 motherboard dev rev.c
    [CONTROLLER.sch, Digital.sch, ENCLOSURE_1550Z113_BOX.FCStd, ENCLOSURE_1550Z113_BOX.step, ENCLOSURE_1550Z113_LID.step, FORCELOG_ADC_MAIN.FCStd, POWER.sch, SD.sch]
2021-03-06 ADC Component
    put adc routines into components
2023-01-02 PCB MB_DEV update 1.1
    +Added a jumper for GPIO12 for flashing and setting efuse for 3.3 Flash operation
    +Added Text Variables to Schematic and PCB
    +introduced versioning of pcb
    +added filenames and version to schematic sheets
2023-01-02 PCB MB-DEV update
    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
    [CONTROLLER.kicad_sch, POWER.kicad_sch, SD.kicad_sch, batmon.kicad_sch, connectors.kicad_sch, ft232.kicad_sch, module_ID.kicad_sch, pcb_motherboard_dev.kicad_sch]
